ExploreEmbedded/ATmega32_ExploreUltraAvrDevKit/Others/Fritzing images/Interfacing KS0108 based JHD12864E Graphics LCD with Atmega32 _bb1.png

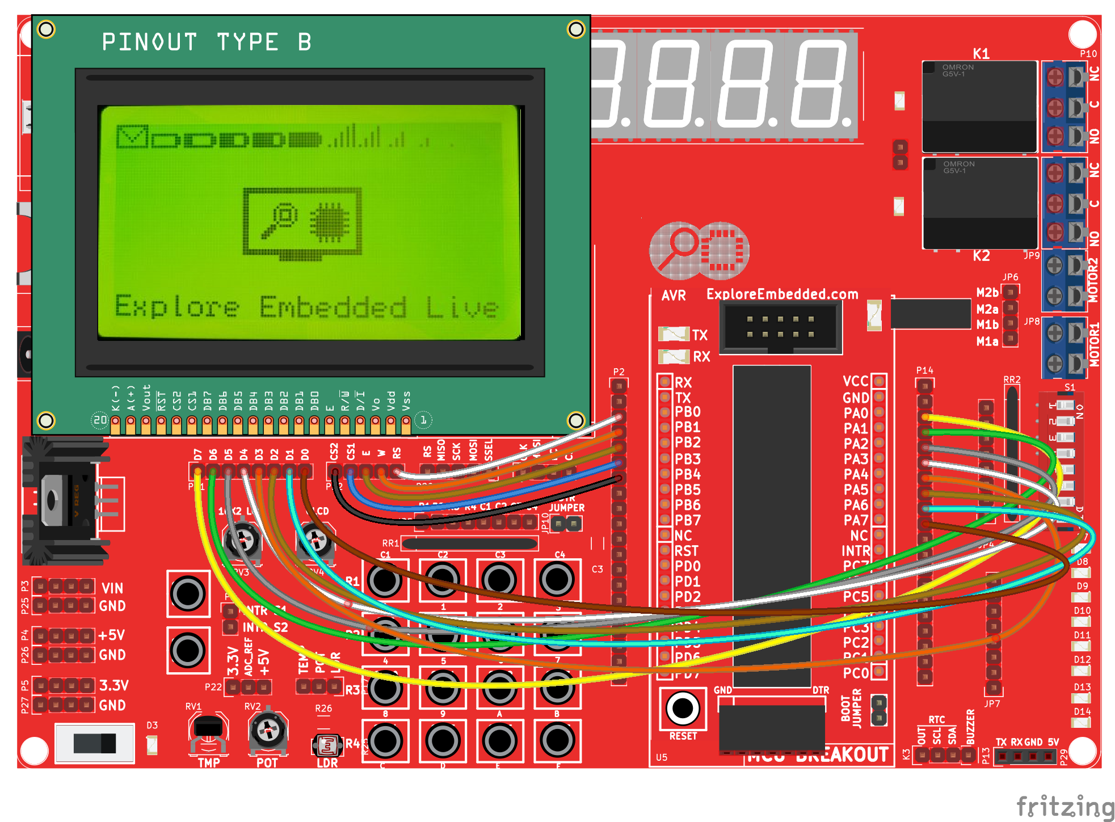
Others/Fritzing images/Interfacing KS0108 based JHD12864E Graphics LCD with Atmega32 _bb1.png
