ExploreEmbedded/ATmega32_ExploreUltraAvrDevKit/Others/Fritzing images/LCD 16X2_AVR.png

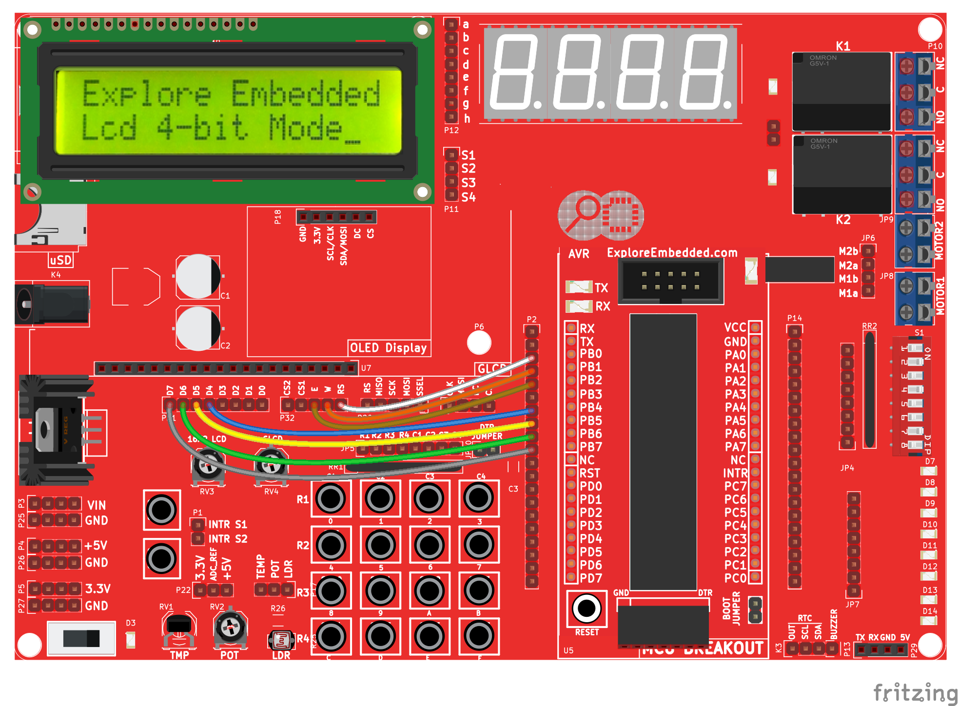
Others/Fritzing images/LCD 16X2_AVR.png
