ExploreEmbedded/ATmega32_ExploreUltraAvrDevKit/Bootloader/README.md

Serial bootloader for Atmega32

# optiboot_atmega32_16Mhz.hex: Fuse Bits
```
low_fuses=0xff
high_fuses=0xde
extended_fuses=0x00
lock_bits=0x0F

Baud Rate=19200
```

Check the below link for flashing the .hex file using XploreFlash tool
https://exploreembedded.com/wiki/Setting_Up_Starter_AVR
Do comment below this utorial for any issues.
