ExploreEmbedded/ATmega32_ExploreUltraAvrDevKit/Others/Fritzing images/10b-Keypad_LCD_bb.png

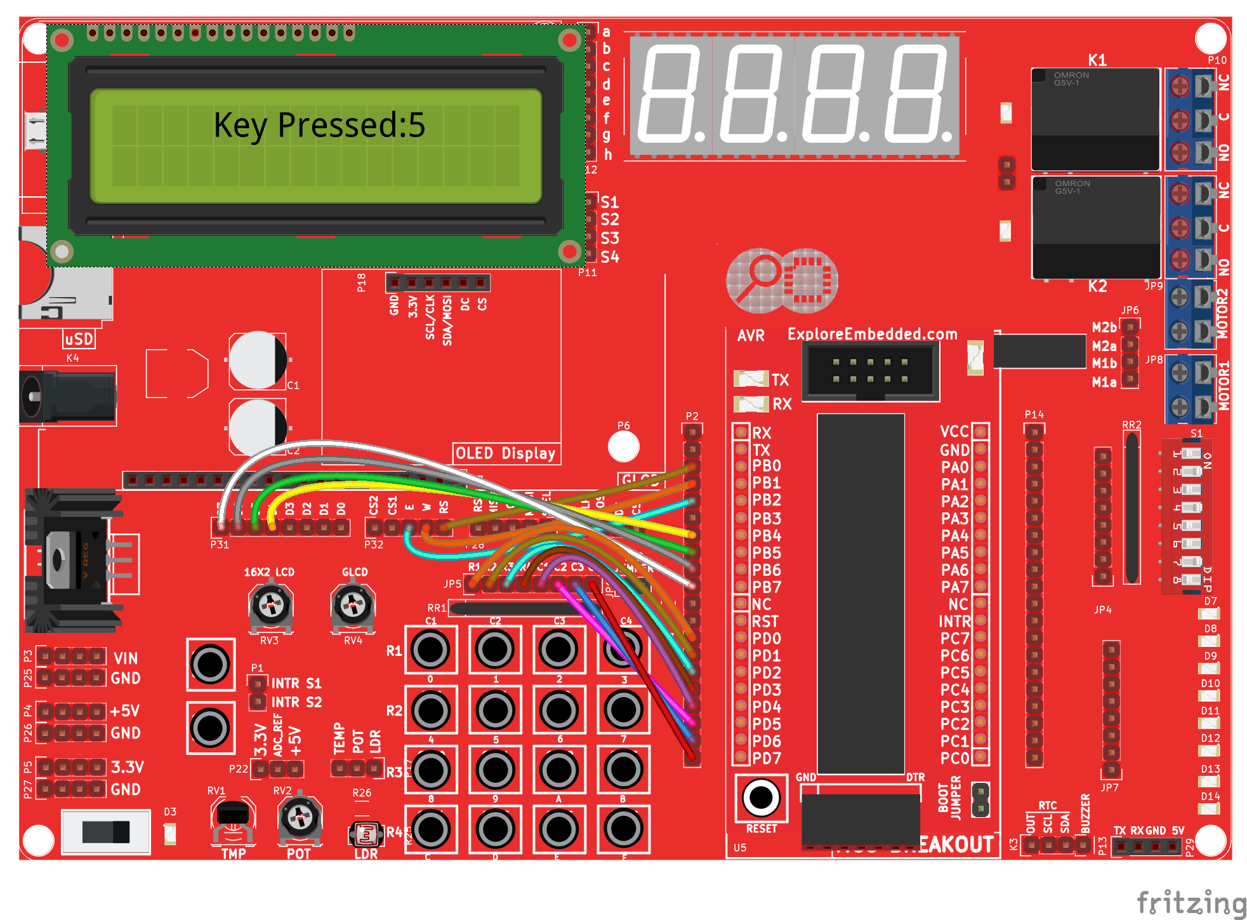
Others/Fritzing images/10b-Keypad_LCD_bb.png
