ExploreEmbedded/ATmega32_ExploreUltraAvrDevKit/Others/Fritzing images/Controlling AC device using Relay_AVR_bb.png

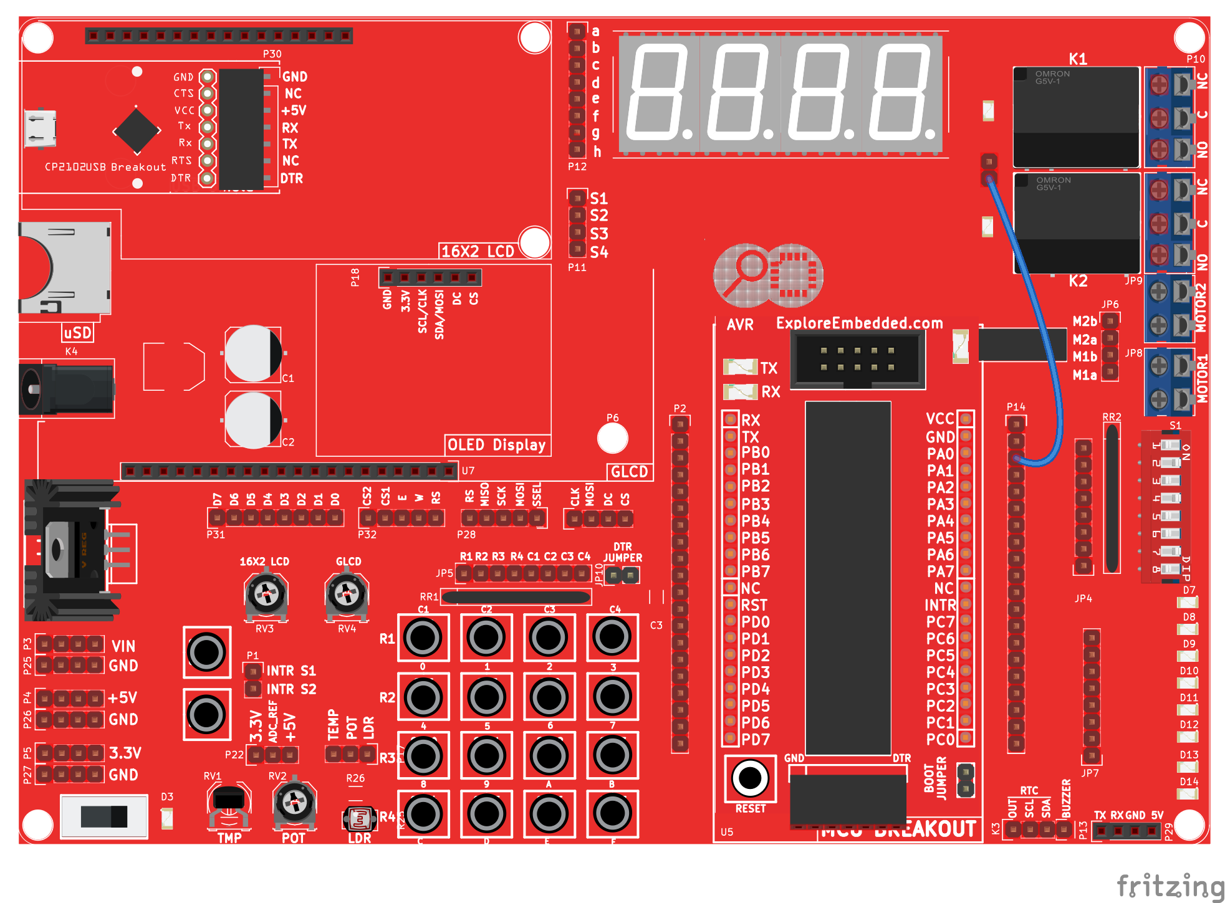
Others/Fritzing images/Controlling AC device using Relay_AVR_bb.png
