ExploreEmbedded/ATmega32_ExploreUltraAvrDevKit/Others/Fritzing images/EXT_Interrupt_Edge_Level.png

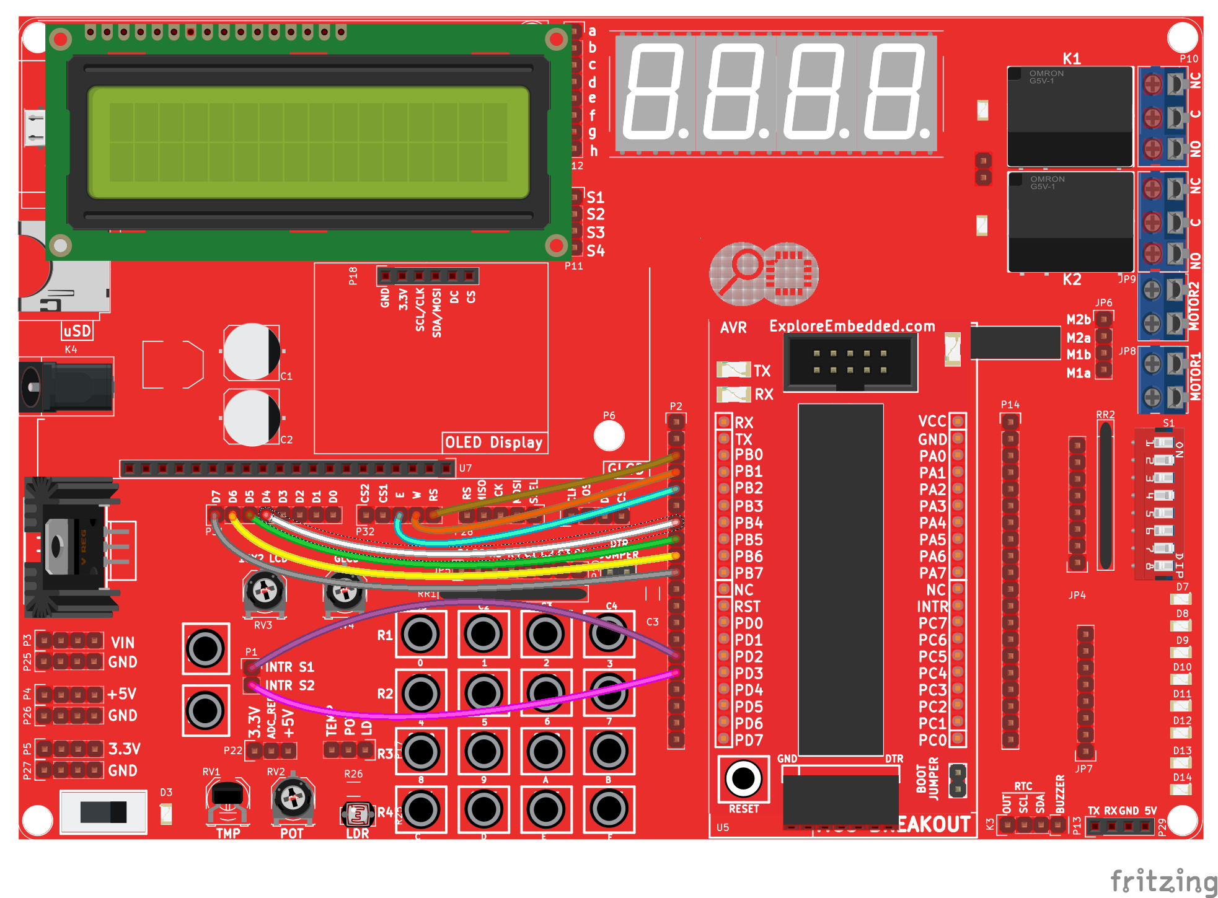
Others/Fritzing images/EXT_Interrupt_Edge_Level.png
