ExploreEmbedded/ATmega32_ExploreUltraAvrDevKit/Others/Fritzing images/Interfacing Seven Segment Displays with AVR_bb.png

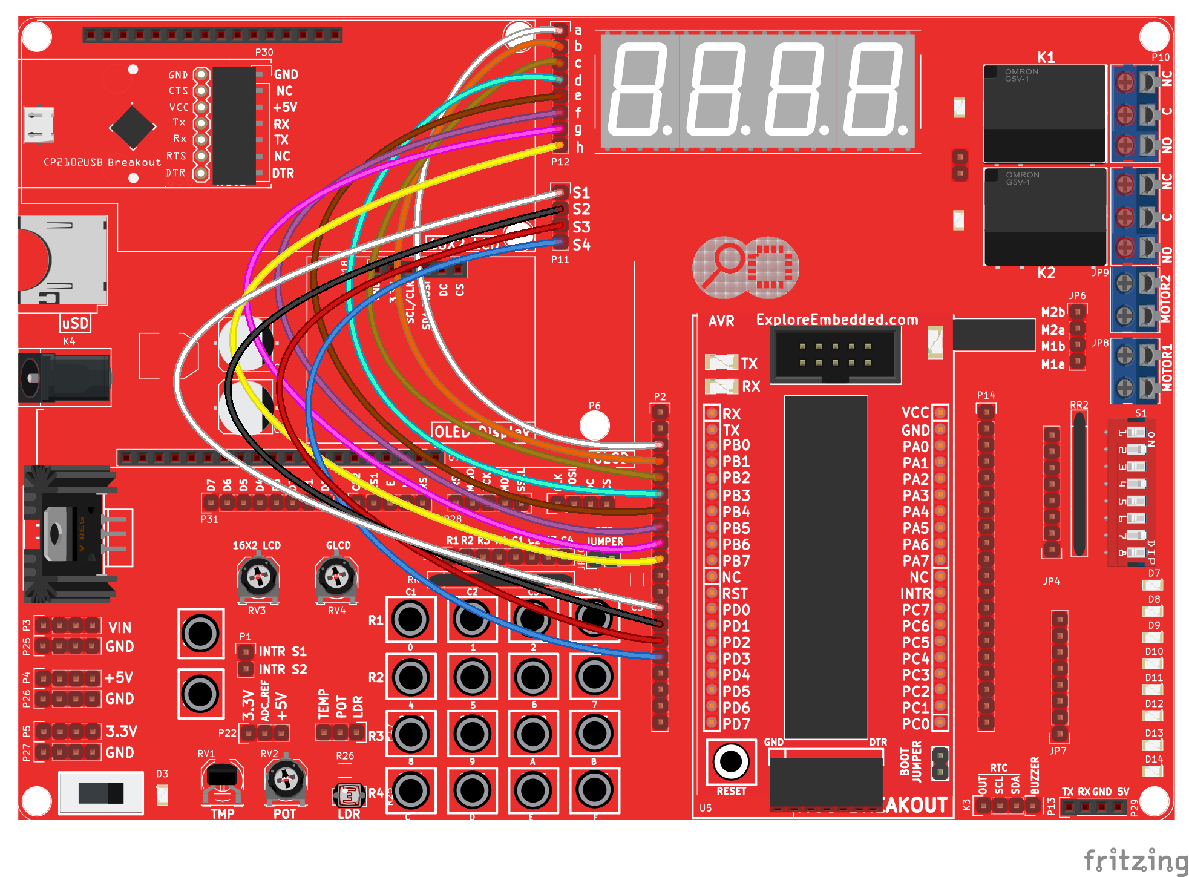
Others/Fritzing images/Interfacing Seven Segment Displays with AVR_bb.png
