ExploreEmbedded/ATmega32_ExploreUltraAvrDevKit/Others/Fritzing images/Real Time Clock(DS1307) with AVR_LCD_RTC.png

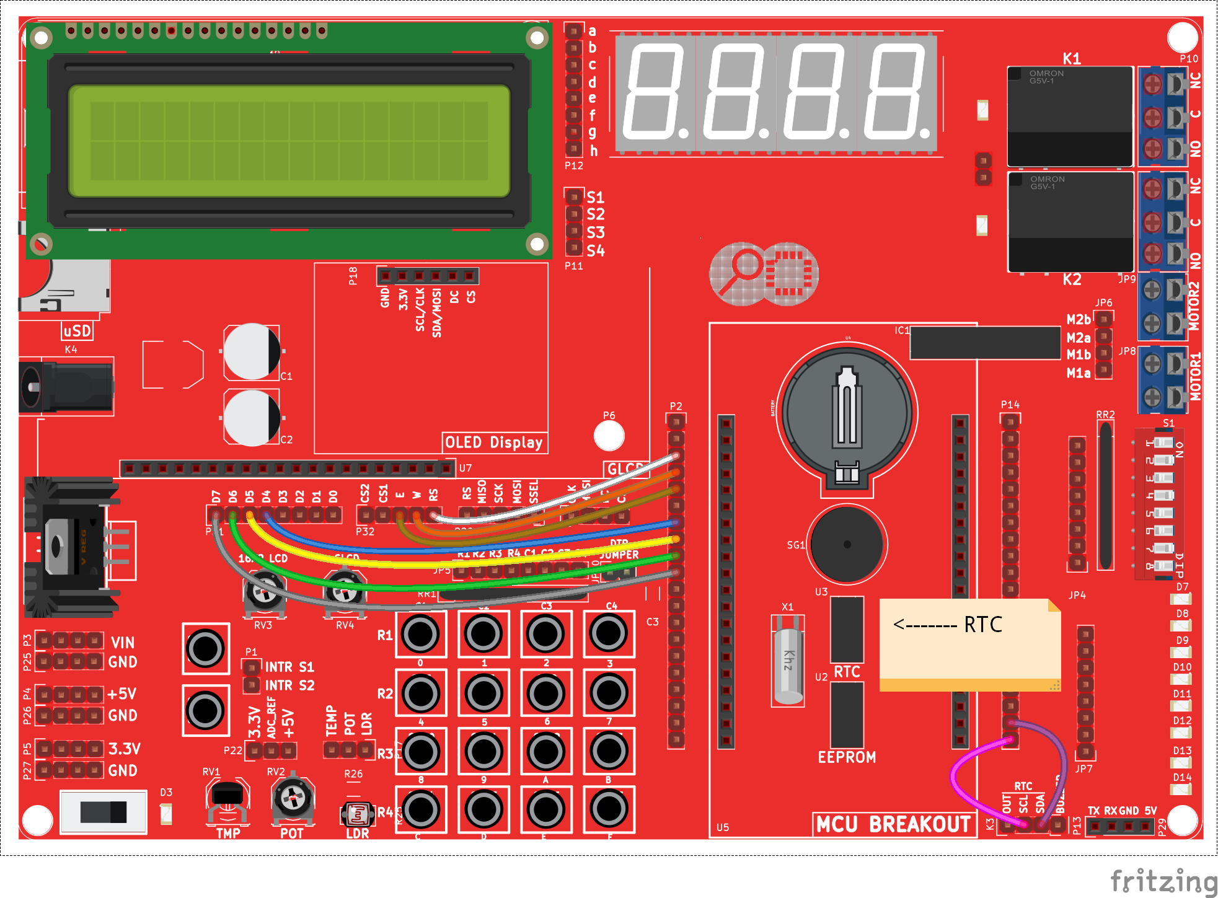
Others/Fritzing images/Real Time Clock(DS1307) with AVR_LCD_RTC.png
