ExploreEmbedded/ATmega32_ExploreUltraAvrDevKit/Hardware Design/Explore Ultra One base board/BOM.xlsx

Id | Designator | Package | Quantity | Designation | 50 quantity | Price | Vendor
1 | SW20 | SPSPT_XL | 1 | SPST | 50
2 | LCD1 | WC1602A | 1 | LCD_2X16_SIL | 50
3 | C1,C2 | c_elec_8x10.5 | 2 | 100uF, 25V | 100
4 | C3 | C_1206_HandSoldering | 1 | 0.1uf | 50
5 | C4 | C_1206_HandSoldering | 1 | 100nF | 50
6 | C5 | C_1206_HandSoldering | 1 | 10uF | 50
7 | D2 | LED-1206 RED | 1 | RL1 | 50
8 | D3,D7,D8,D9,D10,D11,D12,D13,D14,D16 | LED-1206 GREEN | 10 | LED | 500
9 | D4 | LED-1206 GREEN | 1 | RL2 | 50
10 | D5,D6 | Diode-SMA_Handsoldering | 2 | 1N4007 SOD80 | 100
11 | D15 | Diode-SMA_Handsoldering | 1 | 1N4007 SOD80 | 50
12 | D17,D18,D19 | Diode-SMA_Handsoldering | 3 | ZENER 3.3V SOD80 | 150
13 | IC1 | DIP-16__300_ELL | 1 | L293D | 50
14 | IC2 | SOT-223 | 1 | LM1117(3V3) | 50
15 | JP2,JP3 | bornier3 3PIN | 2 | MKDSN | 100
16 | JP4 | Pin_Header_Straight_1x08 | 1 | SWITCH_ARRAY | 50 | 4 stick male
17 | JP5 | Pin_Header_Straight_1x08 | 1 | MATRIX 4X4 | 50 | 2 stick Female
18 | JP6 | Pin_Header_Straight_1x04 | 1 | MOTAR CNTRL | 50 | 1 stick Female R/A
19 | JP7 | Pin_Header_Straight_1x08 | 1 | led array | 50 | 1 stick male long
20 | JP8,JP9 | bornier2 2PIN | 2 | MKDSN | 100
21 | K3 | Pin_Header_Straight_1x03 | 1 | I2C | 50
22 | K4 | BARREL_JACK | 1 | CONN_3 | 50
23 | P3,P4,P5,P25,P26,P27,P29,P17 | Pin_Header_Straight_1x04 | 8 | CONN_01X04 | 400
25 | P11 | Pin_Header_Straight_1x04 | 1 | CONN_4 | 50
26 | P12 | Pin_Header_Straight_1x08 | 1 | CONN_8 | 50
27 | P13 | Pin_Header_Straight_1x01 | 1 | CONN_1 | 50
28 | P22,P15 | Pin_Header_Straight_1x03 | 2 | CONN_01X03 | 100
29 | P28,P32 | Pin_Header_Straight_1x05 | 2 | CONN_01X05 | 100
30 | Q2,Q3,Q4,Q5,Q6,Q7,Q1 | SMD BC847 | 7 | BC847 SMD | 350
31 | R1,R2,R17,R18,R26 | R_1206_HandSoldering | 5 | 10k | 250
32 | R3,R4,R5,R6,R7,R8,R9,R19 | R_1206_HandSoldering | 8 | 1K | 400
33 | R10 | R_1206_HandSoldering | 1 | 10K | 50
34 | R13 | R_1206_HandSoldering | 1 | 2.2k | 50
35 | R14 | R_1206_HandSoldering | 1 | 3.3k | 50
36 | R15 | R_1206_HandSoldering | 1 | 3.3K | 50
37 | R16,R27,R29,R30,R31,R32,R33,R34,R35 | R_1206_HandSoldering | 9 | 470 | 450
38 | R20,R28 | R_1206_HandSoldering | 2 | 33K | 100
39 | R21,R22,R23,R24 | R_1206_HandSoldering | 4 | 68 | 200
40 | RR1,RR2 | Pull uP array 10k | 2 | RR8 | 100
41 | RV1 | LM35 | 1 | TS | 50
42 | RV2 | Potentiometer_Triwood_RM-065 | 1 | POT | 50
43 | RV3,RV4 | Potentiometer_Triwood_RM-065 | 2 | VO | 100
44 | S1 | DIP-16__300_ELL | 1 | SW_DIP-8 | 50
45 | SD1 | Micro_SD | 1 | MICRO_SD | 50
46 | SG1 | Buzzer_12x9.5RM7.6 | 1 | BUZZERPTH | 50
47 | SW2 | SW_PUSH_SMALL_2pin_3D_xl | 1 | C | 50
48 | SW3 | SW_PUSH_SMALL_2pin_3D_xl | 1 | D | 50
49 | SW4 | SW_PUSH_SMALL_2pin_3D_xl | 1 | E | 50
50 | SW5 | SW_PUSH_SMALL_2pin_3D_xl | 1 | F | 50
51 | SW6 | SW_PUSH_SMALL_2pin_3D_xl | 1 | 9 | 50
52 | SW7 | SW_PUSH_SMALL_2pin_3D_xl | 1 | 0 | 50
53 | SW8 | SW_PUSH_SMALL_2pin_3D_xl | 1 | A | 50
54 | SW9 | SW_PUSH_SMALL_2pin_3D_xl | 1 | B | 50
55 | SW10 | SW_PUSH_SMALL_2pin_3D_xl | 1 | 5 | 50
56 | SW11 | SW_PUSH_SMALL_2pin_3D_xl | 1 | 6 | 50
57 | SW12 | SW_PUSH_SMALL_2pin_3D_xl | 1 | 7 | 50
58 | SW13 | SW_PUSH_SMALL_2pin_3D_xl | 1 | 8 | 50
59 | SW14 | SW_PUSH_SMALL_2pin_3D_xl | 1 | 1 | 50
60 | SW15 | SW_PUSH_SMALL_2pin_3D_xl | 1 | 2 | 50
61 | SW16 | SW_PUSH_SMALL_2pin_3D_xl | 1 | 3 | 50
62 | SW17 | SW_PUSH_SMALL_2pin_3D_xl | 1 | 4 | 50
63 | SW18 | SW_PUSH_SMALL_2pin_3D_xl | 1 | INT0 | 50
64 | SW19 | SW_PUSH_SMALL_2pin_3D_xl | 1 | INT1 | 50
65 | U2 | DIP-8__300_ELL and IC | 1 | 24C16 | 50
66 | U3 | DIP-8__300_ELL and IC | 1 | DS1307 | 50
67 | U4 | BATT_rtc_XL | 1 | BATTERY | 50
68 | U7 | Pin_Header_Straight_1x20 | 1 | LCD-jhd12864e-xl | 50
69 | JP1 | Pin_Header_Straight_1x02 | 1 | RELAY | 50
70 | JP10 | Pin_Header_Straight_1x02 | 1 | JUMPER | 50
71 | K1,K2 | 5V AIFU Relays | 2 | RELAYPTH | 100
72 | U1 | 1A regulator | 1 | 7805 | 50
73 | R25 | Pin_Header_Straight_1x02 | 1 | LDR | 50
74 | P30 | Pin_Header_Straight_1x07 | 1 | CONN_01X07 | 50
75 | P31 | Pin_Header_Straight_1x08 | 1 | CONN_01X08 | 50
76 | P1 | Pin_Header_Straight_1x02 | 1 | CONN_01X02 | 50
77 | AFF2,AFF3,AFF4,AFF1 | 7SegmentLED_LT542 | 4 | LT542 CA | 200
79 | P2,P14 | Pin_Header_Straight_1x20 | 2 | CONN_01X20 | 100
80 | X1 | RTC_Crystal | 1 | 32.768kHZ | 50
