ExploreEmbedded/ATmega32_ExploreUltraAvrDevKit/(list of files, cad)

Other CAD files:
Hardware Design/Explore Ultra One base board/MCU_BaseBoard-drl_map.dxf
Hardware Design/Explore Ultra One base board/MCU_BaseBoard-NPTH-drl_map.dxf
