ExploreEmbedded/ATmega32_ExploreUltraAvrDevKit/Hardware Design/Explore Ultra One base board/MCU_BaseBoard.pdf

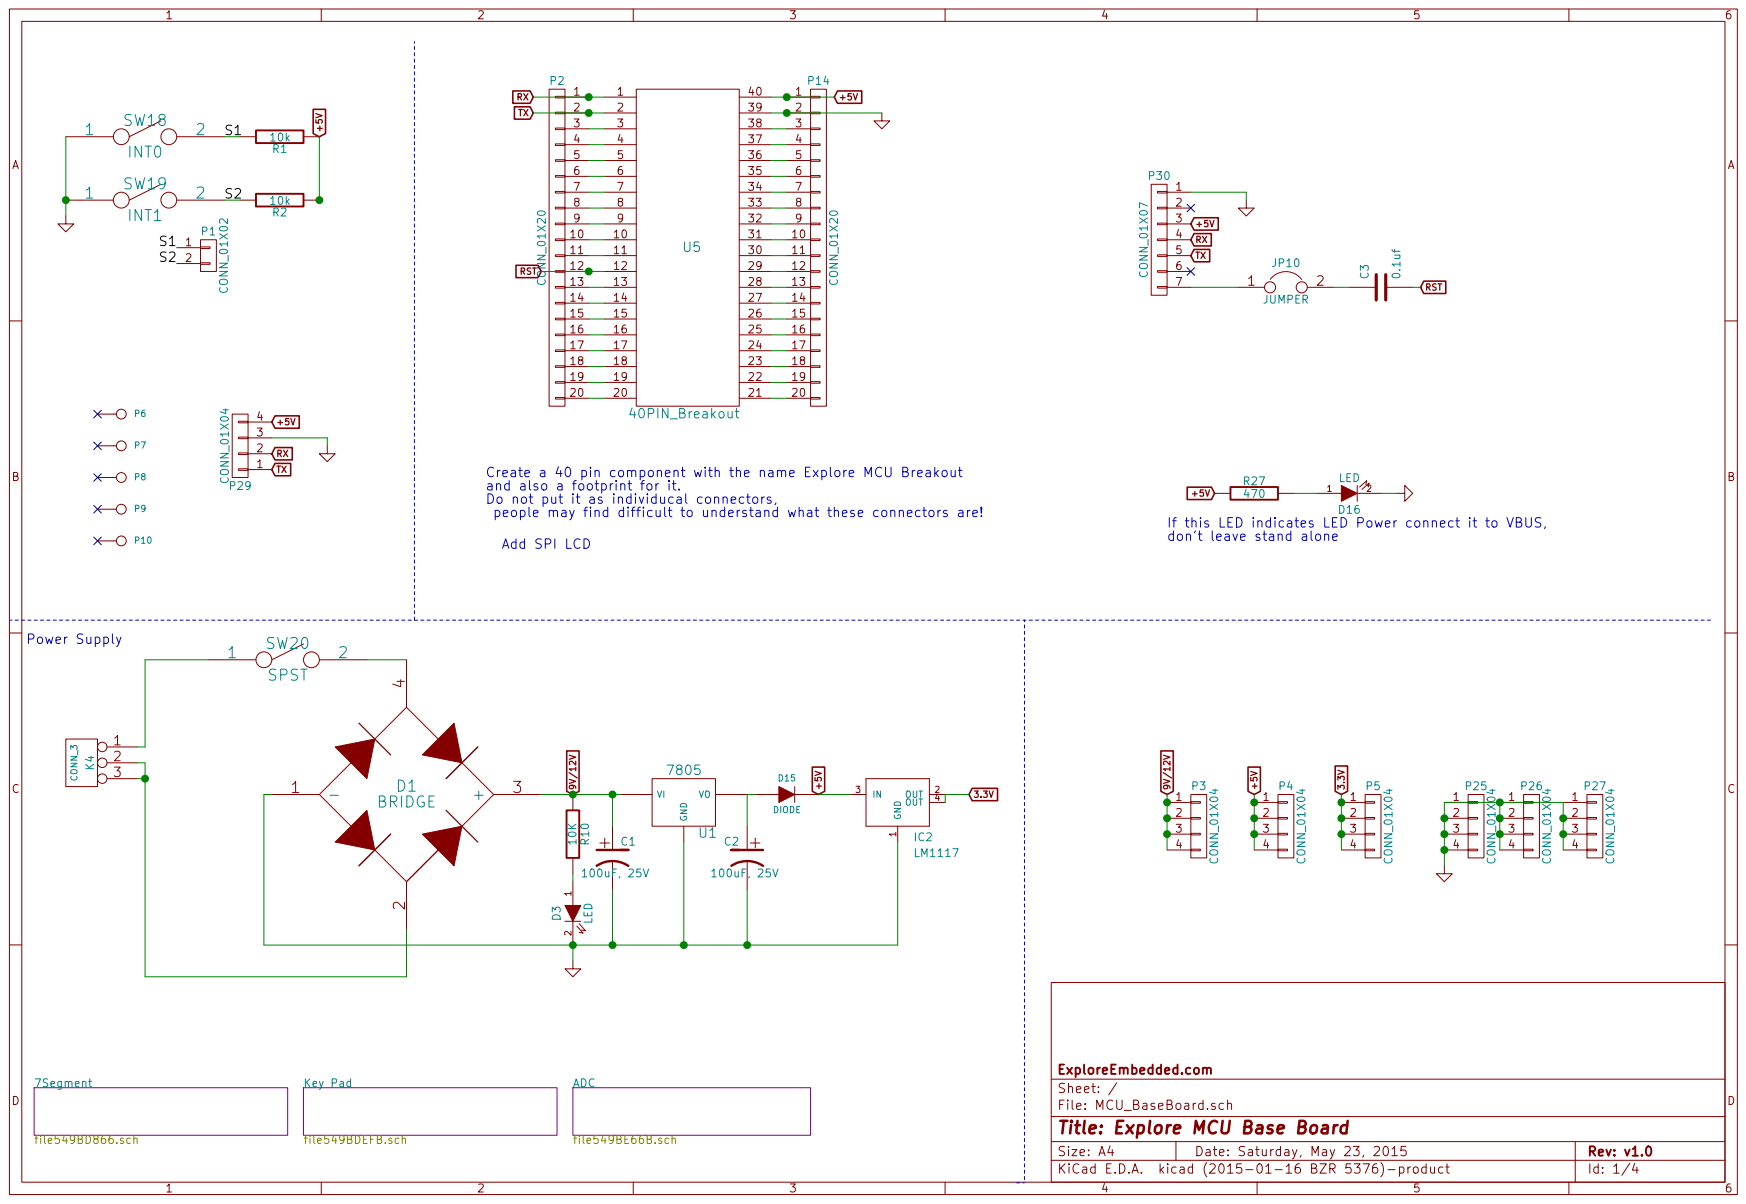
[picture p8: page 1]

6 6 | 35 6
7 7 | 34 7

9 9 | 32 9
10 10 | 31 10
11 11 | 30 11
12 12 | 29 12
13 13 | 28 13
14 14 | 27 14
15 15 | 26 15
16 16 | 25 16
17 17 | 24 17
18 18 | 23 18

7805 Create a 40 pin component with the name Explore MCU Breakout
and also a footprint for it.
Do not put it as individucal connectors,
people may find difficult to understand what these connectors are!
If this LED indicates LED Power connect it to VBUS, don't leave stand alone Add SPI LCD

File: MCU_BaseBoard.sch Sheet: / ExploreEmbedded.com

Id: 1/4 Title: Explore MCU Base Board

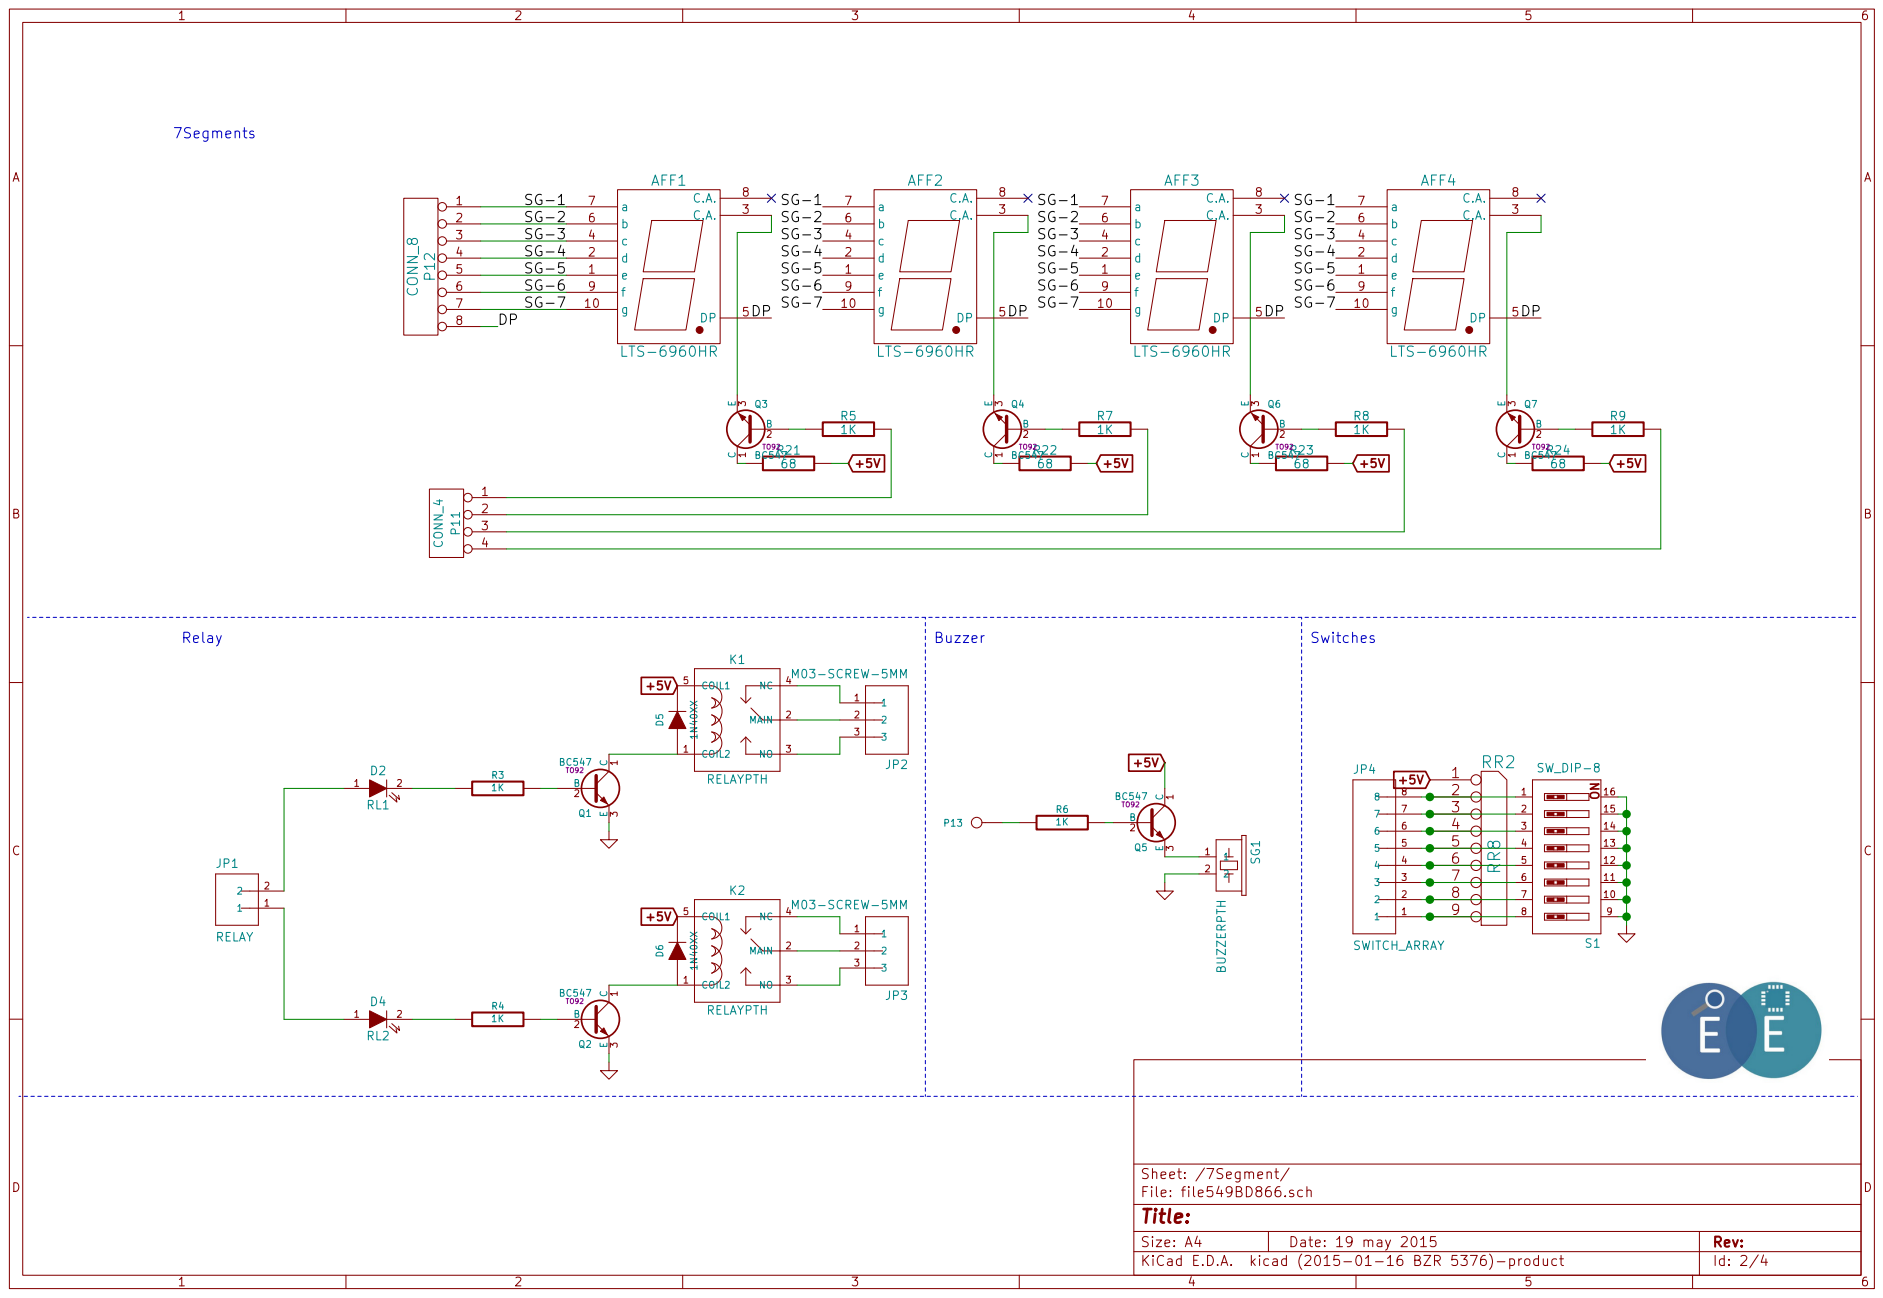
[picture p9: page 2]

Id: 2/4 Title: File: file549BD866.sch Sheet: /7Segment/

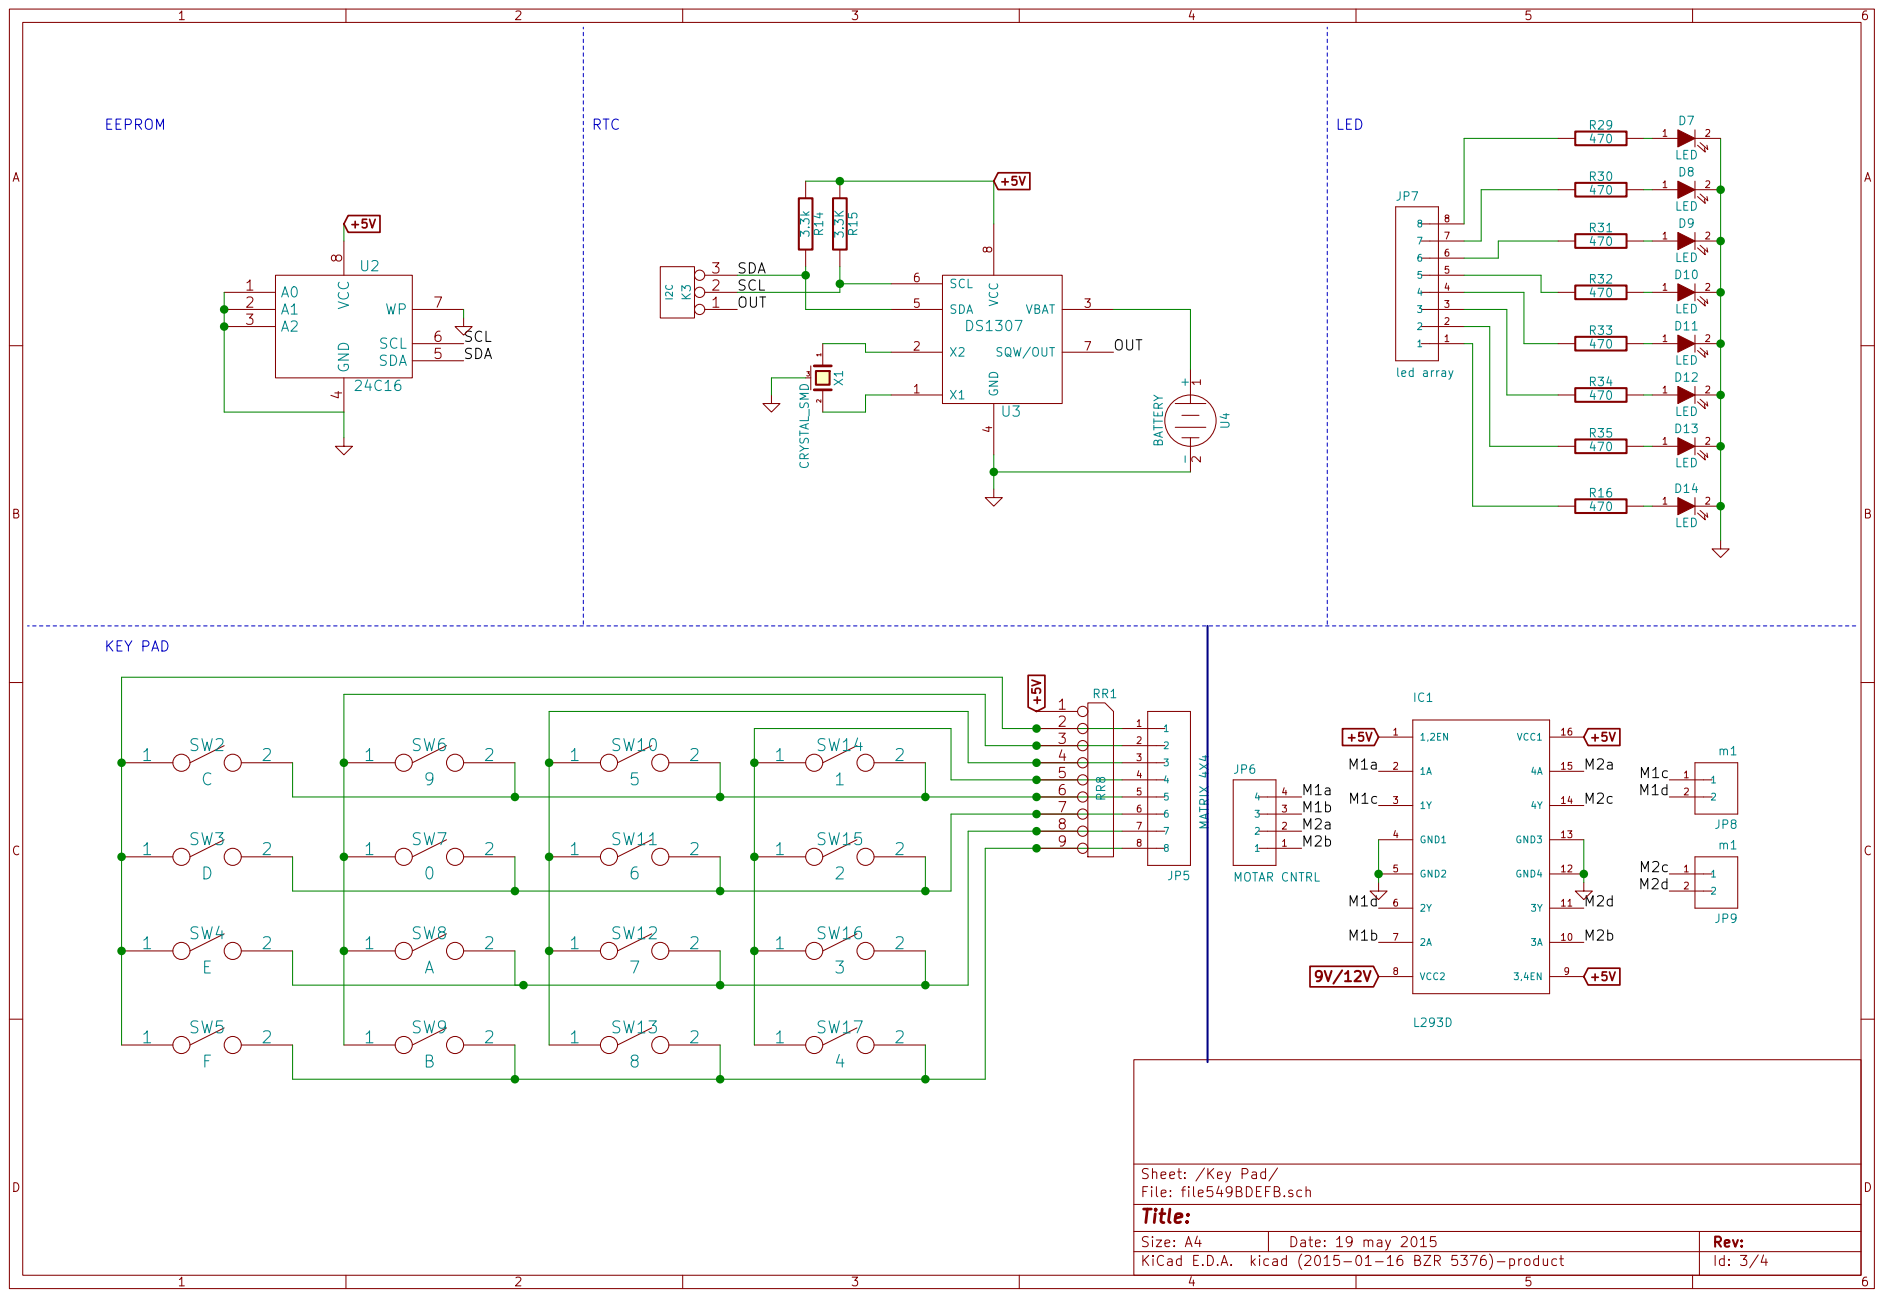
[picture p10: page 3]

4 SDA 5 SCL 6 SQW/OUT 7 VCC

Id: 3/4 Title: File: file549BDEFB.sch Sheet: /Key Pad/

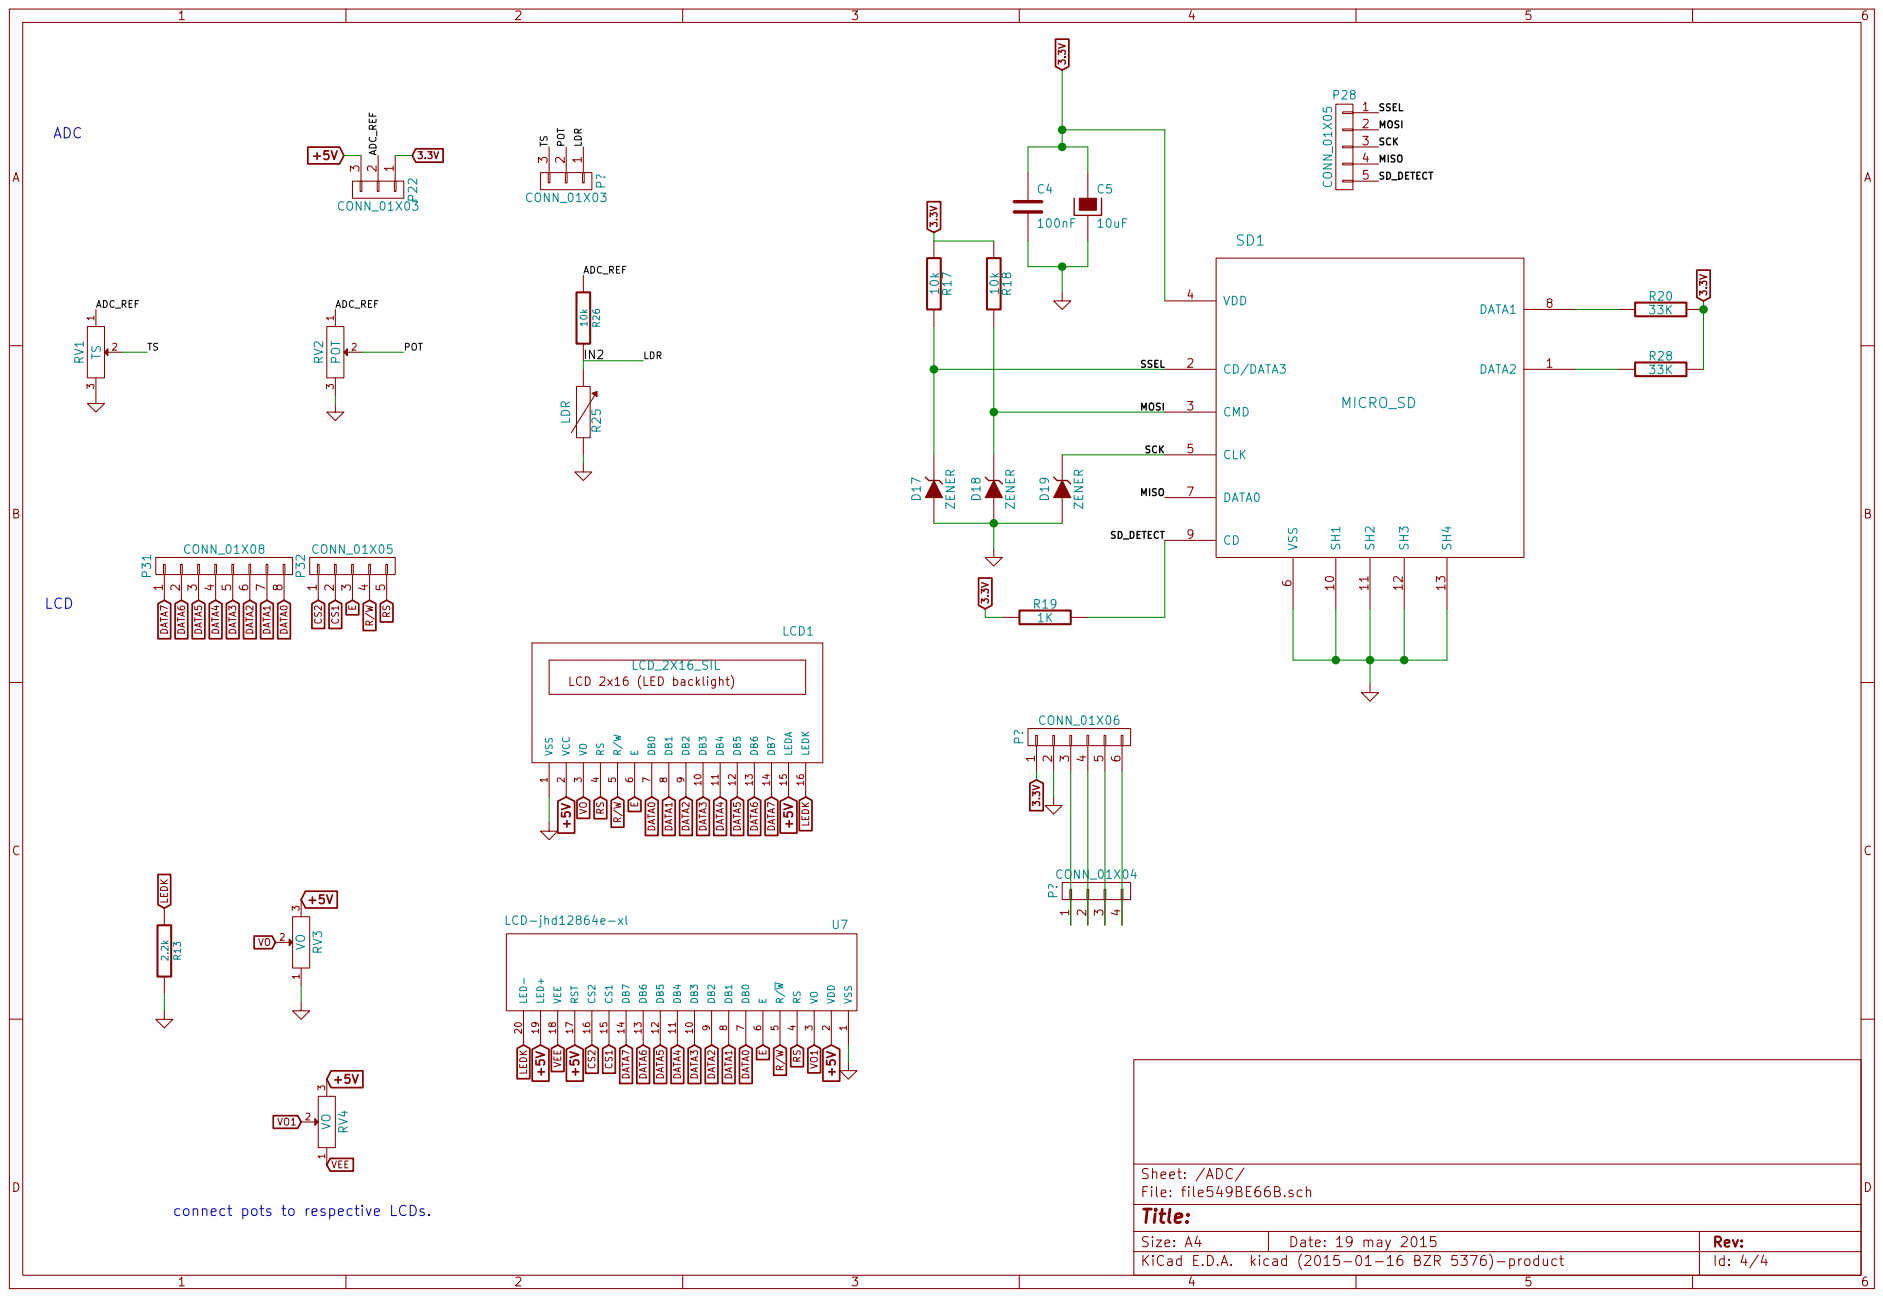
[picture p11: page 4]

33K SSEL MOSI SCK MISO

9 DB3 10 LED- 20 DB4 11 DB5 12 DB6 13 DB7 14 CS1 15 CS2 16 RST 17 VEE 18 LED+ 19 U7 LCD-jhd12864e-xl DATA7 DATA6 DATA5 DATA4 DATA3 DATA2 DATA1 DATA0E R/WRS CS2 CS1 2.2k R13

LCD 2x16 (LED backlight) VSS

Id: 4/4 Title: File: file549BE66B.sch Sheet: /ADC/

connect pots to respective LCDs.
