ExploreEmbedded/ATmega32_ExploreUltraAvrDevKit/Hardware Design/Atmega32 Breakout Board/40pin_AVRMCU.pdf

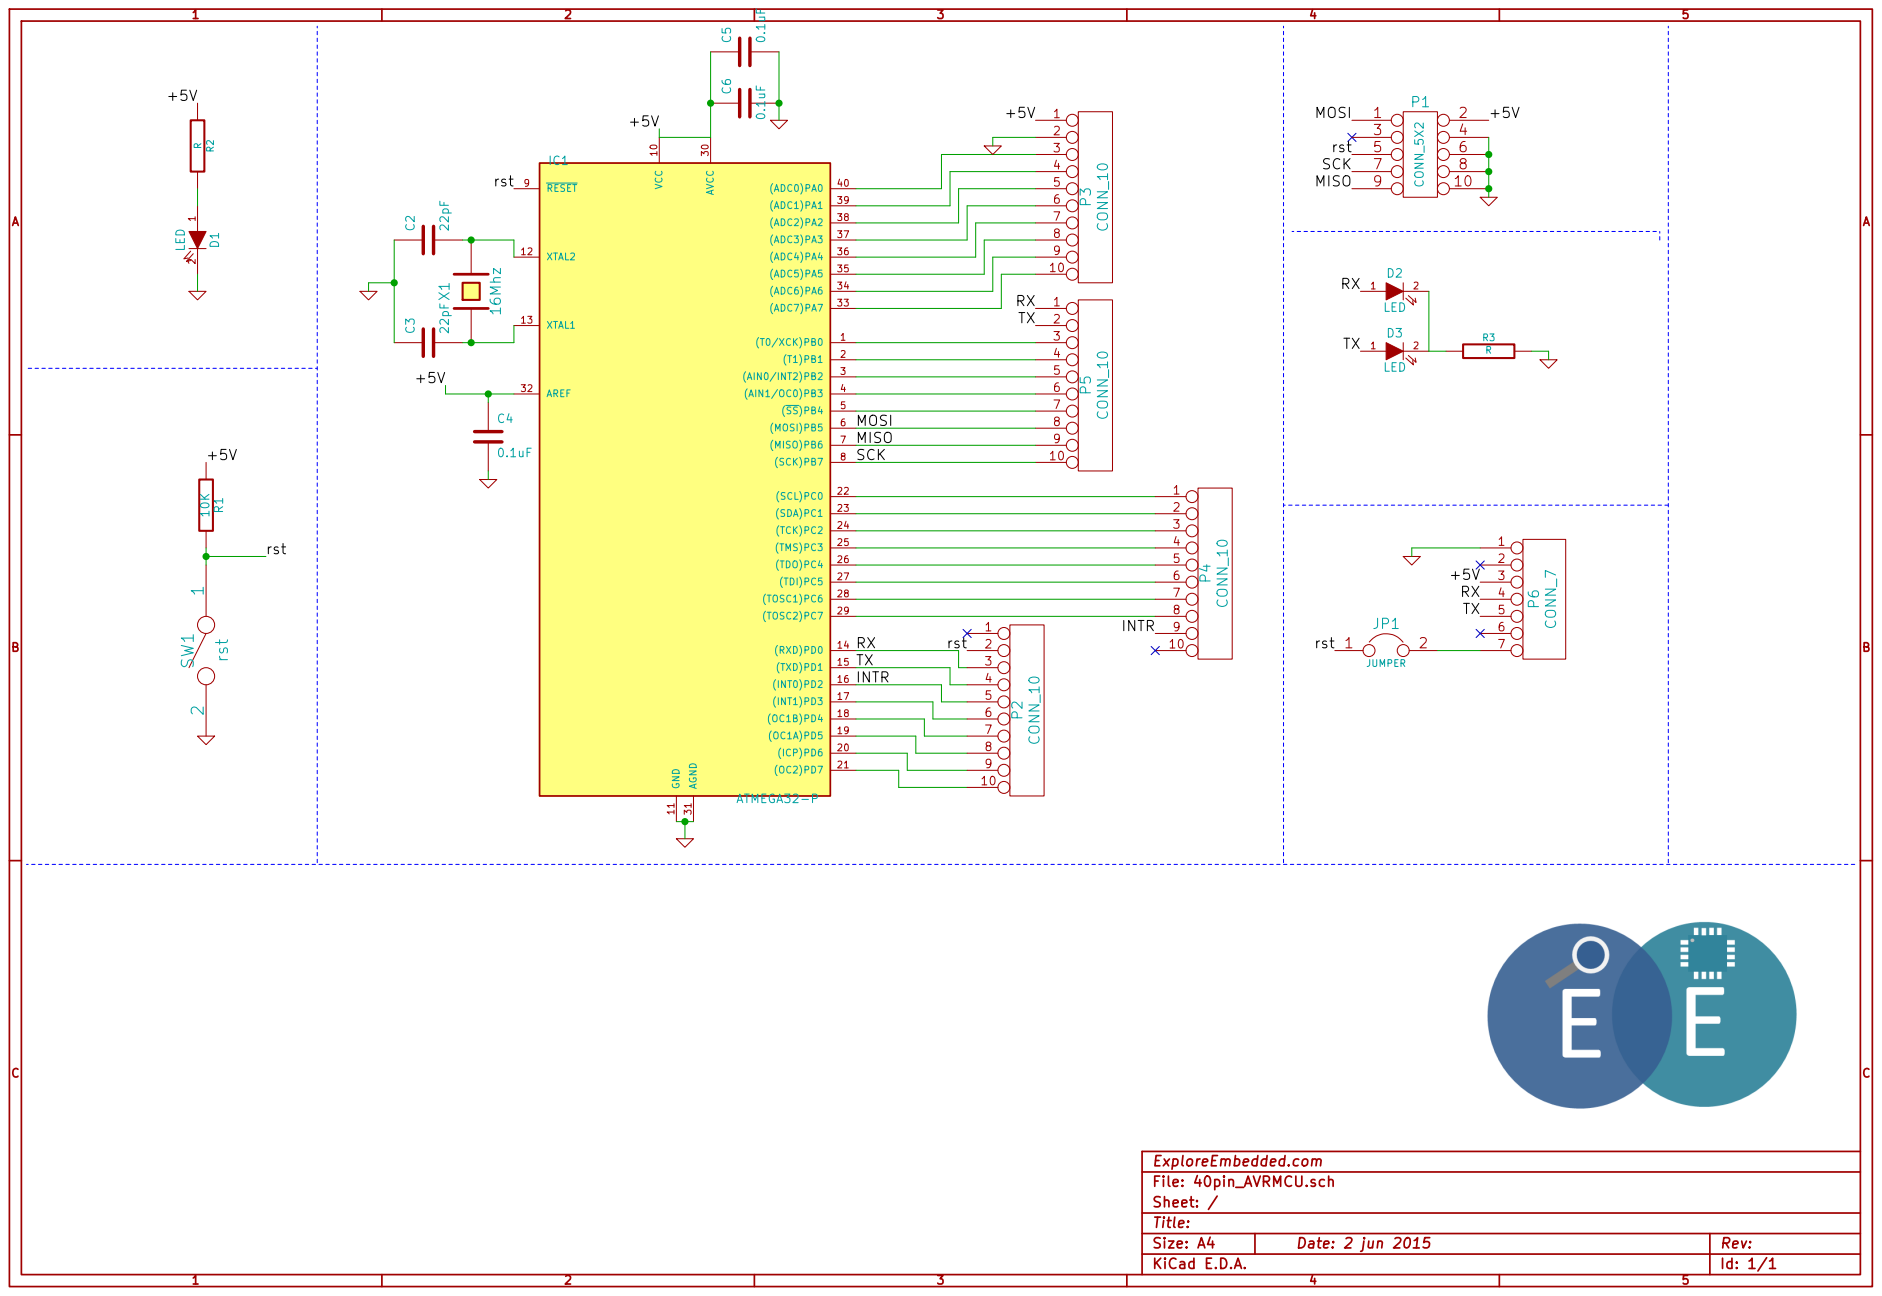
[picture p12: page 1]

TX
INTR

ExploreEmbedded.com
Id: 1/1 Title: File: 40pin_AVRMCU.sch
Sheet: /
