ExploreEmbedded/ATmega32_ExploreUltraAvrDevKit/(list of files, drawings)

Other design files:
Others/Fritzing images/10b-Keypad_LCD.fzz
Others/Fritzing images/Controlling AC device using Relay_AVR.fzz
Others/Fritzing images/EXT_Interrupt_Edge_Level.fzz
Others/Fritzing images/Interfacing KS0108 based JHD12864E Graphics LCD with Atmega32 .fzz
Others/Fritzing images/Interfacing Seven Segment Displays with AVR.fzz
Others/Fritzing images/LCD 16X2_AVR.fzz
Others/Fritzing images/Reading Temperature with AVR ADC.fzz
Others/Fritzing images/Reading Temperature with AVR ADC_TEMP.fzz
Others/Fritzing images/Real Time Clock(DS1307) with AVR_LCD.fzz
