ExploreEmbedded/ATmega32_ExploreUltraAvrDevKit/Hardware Design/Atmega32 Breakout Board/40pin_AVRMCU.kicad_pcb

## KiCad design Hardware Design/Atmega32 Breakout Board/40pin_AVRMCU.kicad_pcb (2016-04-19)

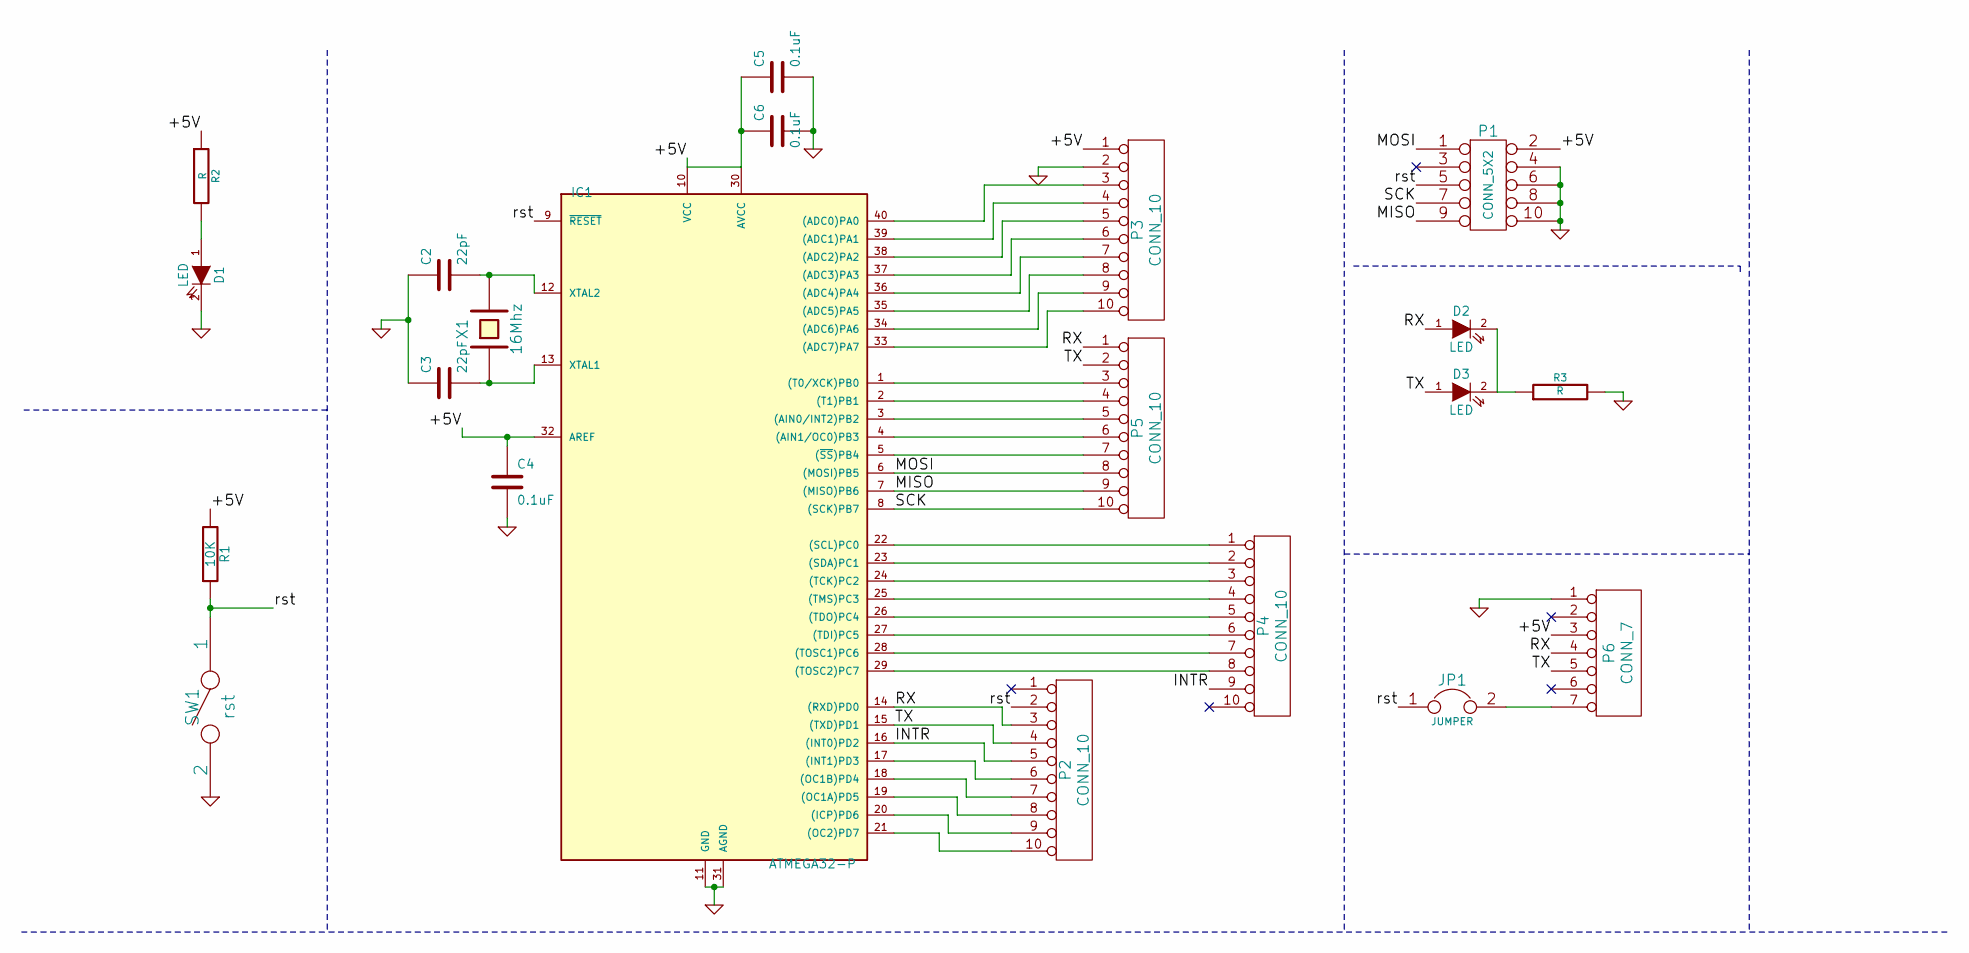
[picture p13: schematic 40pin_AVRMCU.sch]

Parts:
C2, C3: 22pF
C4, C5, C6: 0.1uF
D1, D2, D3: LED
IC1: ATMEGA32-P; DIL40
JP1: JUMPER
P1: CONN_5X2
P2, P3, P4, P5: CONN_10
P6: CONN_7
R1: 10K
R2, R3: R
SW1: rst
X1: 16Mhz

Connections:
/+5V: C4.1, C5.1, C6.1, IC1.10 (VCC), IC1.30 (AVCC), IC1.32 (AREF), P1.2, P3.1, P6.3, R1.2, R2.1
/INTR: IC1.16 ((INT0)PD2), P2.5, P4.9
/MISO: IC1.7 ((MISO)PB6), P1.9, P5.9
/MOSI: IC1.6 ((MOSI)PB5), P1.1, P5.8
/RX: D2.1 (A), IC1.14 ((RXD)PD0), P2.3, P5.1, P6.4
/SCK: IC1.8 ((SCK)PB7), P1.7, P5.10
/TX: D3.1 (A), IC1.15 ((TXD)PD1), P2.4, P5.2, P6.5
/rst: IC1.9 (~RESET), JP1.1, P1.5, P2.2, R1.1, SW1.1
GND: C2.1, C3.1, C4.2, C5.2, C6.2, D1.2 (K), IC1.11 (GND), IC1.31 (AGND), P1.4, P1.6, P1.8, P1.10, P3.2, P6.1, R3.2, SW1.2
unnamed: IC1.34 ((ADC6)PA6), P3.9
unnamed: IC1.33 ((ADC7)PA7), P3.10
unnamed: IC1.35 ((ADC5)PA5), P3.8
unnamed: IC1.36 ((ADC4)PA4), P3.7
unnamed: IC1.37 ((ADC3)PA3), P3.6
unnamed: IC1.39 ((ADC1)PA1), P3.4
unnamed: IC1.40 ((ADC0)PA0), P3.3
unnamed: IC1.38 ((ADC2)PA2), P3.5
unnamed: IC1.20 ((ICP)PD6), P2.9
unnamed: IC1.2 ((T1)PB1), P5.4
unnamed: IC1.1 ((T0/XCK)PB0), P5.3
unnamed: IC1.21 ((OC2)PD7), P2.10
unnamed: IC1.3 ((AIN0/INT2)PB2), P5.5
unnamed: IC1.19 ((OC1A)PD5), P2.8
unnamed: IC1.18 ((OC1B)PD4), P2.7
unnamed: IC1.5 ((~SS~)PB4), P5.7
unnamed: IC1.4 ((AIN1/OC0)PB3), P5.6
unnamed: D2.2 (K), D3.2 (K), R3.1
unnamed: JP1.2, P6.7
unnamed: IC1.17 ((INT1)PD3), P2.6
unnamed: D1.1 (A), R2.2
unnamed: C2.2, IC1.12 (XTAL2), X1.2
unnamed: IC1.24 ((TCK)PC2), P4.3
unnamed: IC1.23 ((SDA)PC1), P4.2
unnamed: IC1.22 ((SCL)PC0), P4.1
unnamed: IC1.29 ((TOSC2)PC7), P4.8
unnamed: IC1.28 ((TOSC1)PC6), P4.7
unnamed: IC1.27 ((TDI)PC5), P4.6
unnamed: IC1.26 ((TDO)PC4), P4.5
unnamed: IC1.25 ((TMS)PC3), P4.4
unnamed: C3.2, IC1.13 (XTAL1), X1.1

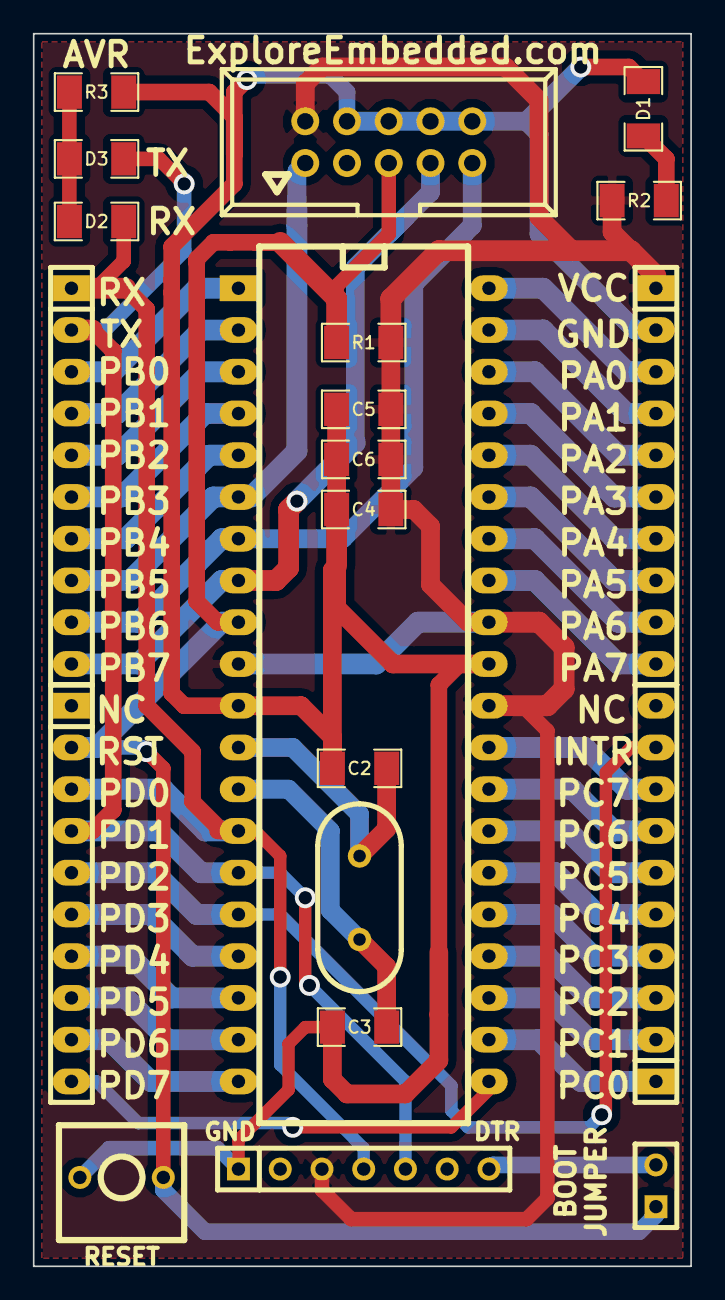
[picture p14: board 40pin_AVRMCU.kicad_pcb from above]

Board: 2 copper layers, 40.0 x 75.0 mm, 21 parts (0 on the bottom side), 40 nets.
