ExploreEmbedded/ATmega32_ExploreUltraAvrDevKit/Hardware Design/Explore Ultra One base board/MCU_BaseBoard.kicad_pcb

## KiCad design Hardware Design/Explore Ultra One base board/MCU_BaseBoard.kicad_pcb (2016-04-19)

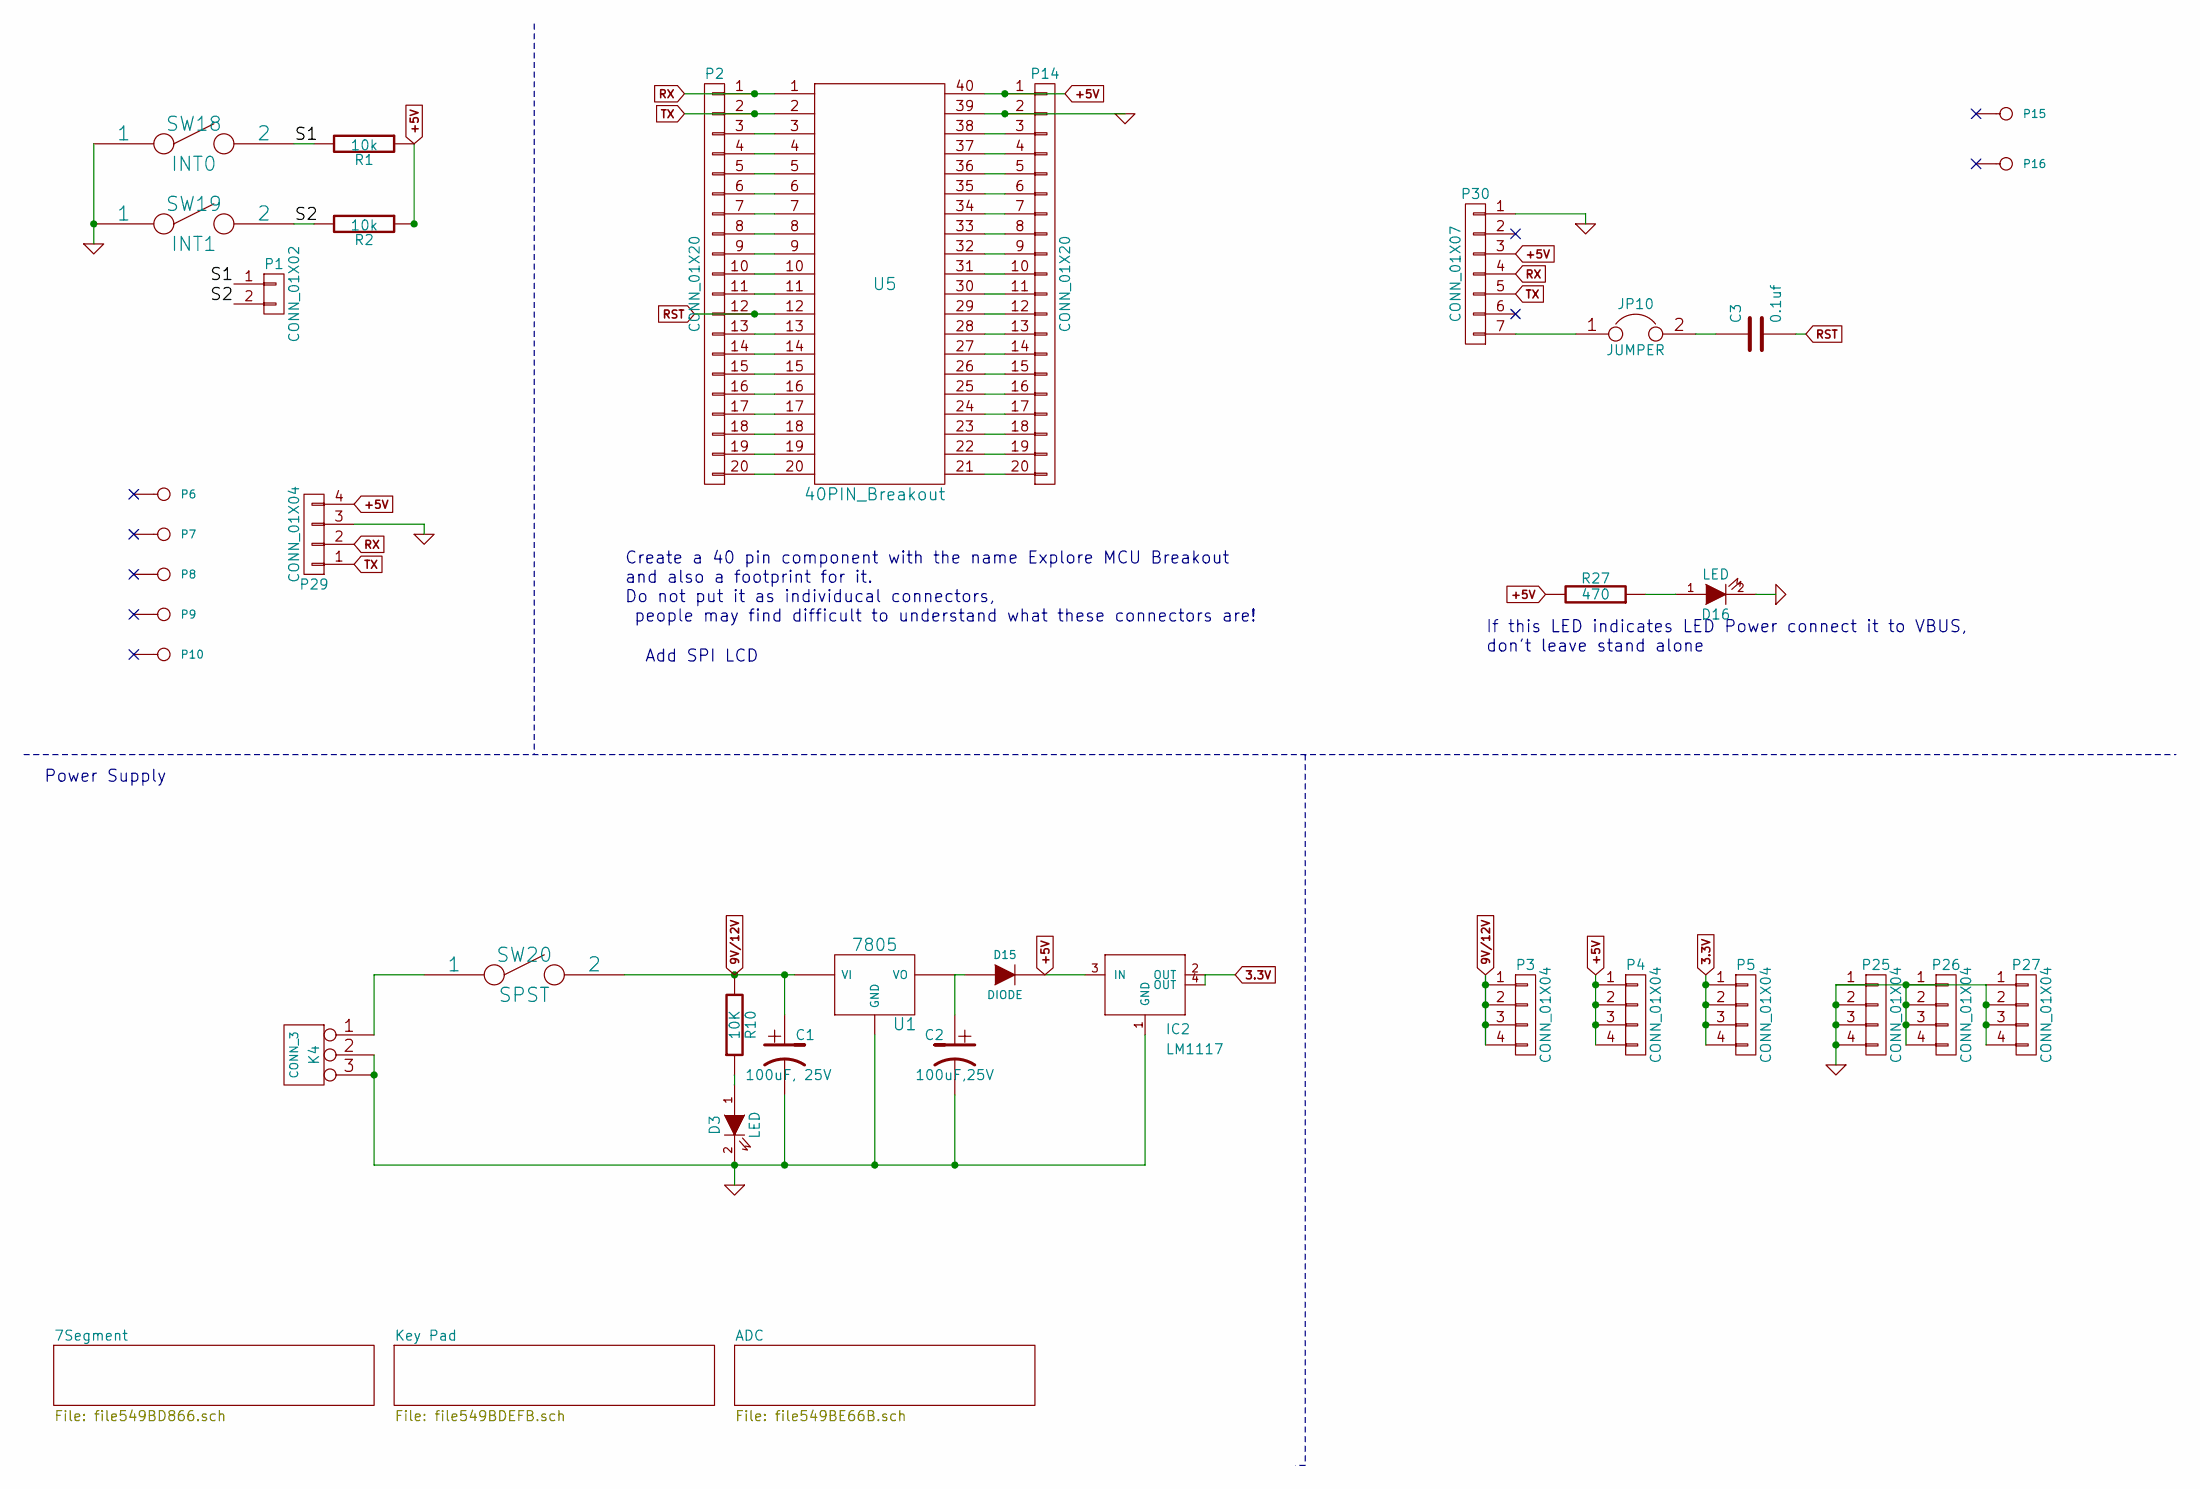
[picture p15: schematic MCU_BaseBoard.sch, Explore MCU Base Board]

Parts:
C1: 100uF, 25V
C2: 100uF,25V
C3: 0.1uf
D3, D16: LED
D15: DIODE
IC2: LM1117
JP10: JUMPER
K4: CONN_3
P1: CONN_01X02
P2, P14: CONN_01X20
P3, P4, P5, P25, P26, P27, P29: CONN_01X04
P6, P7, P8, P9, P10, P15, P16: CONN_1
P30: CONN_01X07
R1, R2: 10k
R10: 10K
R27: 470
SW18: INT0
SW19: INT1
SW20: SPST
U1: 7805
U5: 40PIN_Breakout

Connections:
3.3V: IC2.2 (OUT), IC2.4 (OUT), P5.1, P5.2, P5.3, P5.4; also elsewhere on the board
9V/12V: C1.1, P3.1, P3.2, P3.3, P3.4, R10.2, SW20.2, U1.VI; also elsewhere on the board
+5V: D15.2 (K), IC2.3 (IN), P4.1, P4.2, P4.3, P4.4, P14.1, P29.4, P30.3, R1.1, R2.1, R27.2, U5.40; also elsewhere on the board
/S1: P1.1, R1.2, SW18.2
/S2: P1.2, R2.2, SW19.2
GND: C1.2, C2.2, D3.2 (K), D16.2 (K), IC2.1 (GND), K4.2 (PM), K4.3, P14.2, P25.1, P25.2, P25.3, P25.4, P26.1, P26.2, P26.3, P26.4, P27.1, P27.2, P27.3, P27.4, P29.3, P30.1, SW18.1, SW19.1, U1.GND, U5.39; also elsewhere on the board
unnamed: C2.1, D15.1 (A), U1.VO
unnamed: C3.1, JP10.2
unnamed: D3.1 (A), R10.1
unnamed: D16.1 (A), R27.1
unnamed: JP10.1, P30.7
unnamed: K4.1, SW20.1
unnamed: P2.3, U5.3
unnamed: P2.4, U5.4
unnamed: P2.5, U5.5
unnamed: P2.6, U5.6
unnamed: P2.7, U5.7
unnamed: P2.8, U5.8
unnamed: P2.9, U5.9
unnamed: P2.10, U5.10
unnamed: P2.11, U5.11
unnamed: P2.13, U5.13
unnamed: P2.14, U5.14
unnamed: P2.15, U5.15
unnamed: P2.16, U5.16
unnamed: P2.17, U5.17
unnamed: P2.18, U5.18
unnamed: P2.19, U5.19
unnamed: P2.20, U5.20
unnamed: P14.3, U5.38
unnamed: P14.4, U5.37
unnamed: P14.5, U5.36
unnamed: P14.6, U5.35
unnamed: P14.7, U5.34
unnamed: P14.8, U5.33
unnamed: P14.9, U5.32
unnamed: P14.10, U5.31
unnamed: P14.11, U5.30
unnamed: P14.12, U5.29
unnamed: P14.13, U5.28
unnamed: P14.14, U5.27
unnamed: P14.15, U5.26
unnamed: P14.16, U5.25
unnamed: P14.17, U5.24
unnamed: P14.18, U5.23
unnamed: P14.19, U5.22
unnamed: P14.20, U5.21
RST: C3.2, P2.12, U5.12
RX: P2.1, P29.2, P30.4, U5.1
TX: P2.2, P29.1, P30.5, U5.2

Notes on the sheet:
Power Supply
Create a 40 pin component with the name Explore MCU Breakout and also a footprint for it. Do not put it as individucal connectors, people may find difficult to understand what these connectors are!
If this LED indicates LED Power connect it to VBUS, don't leave stand alone
Add SPI LCD

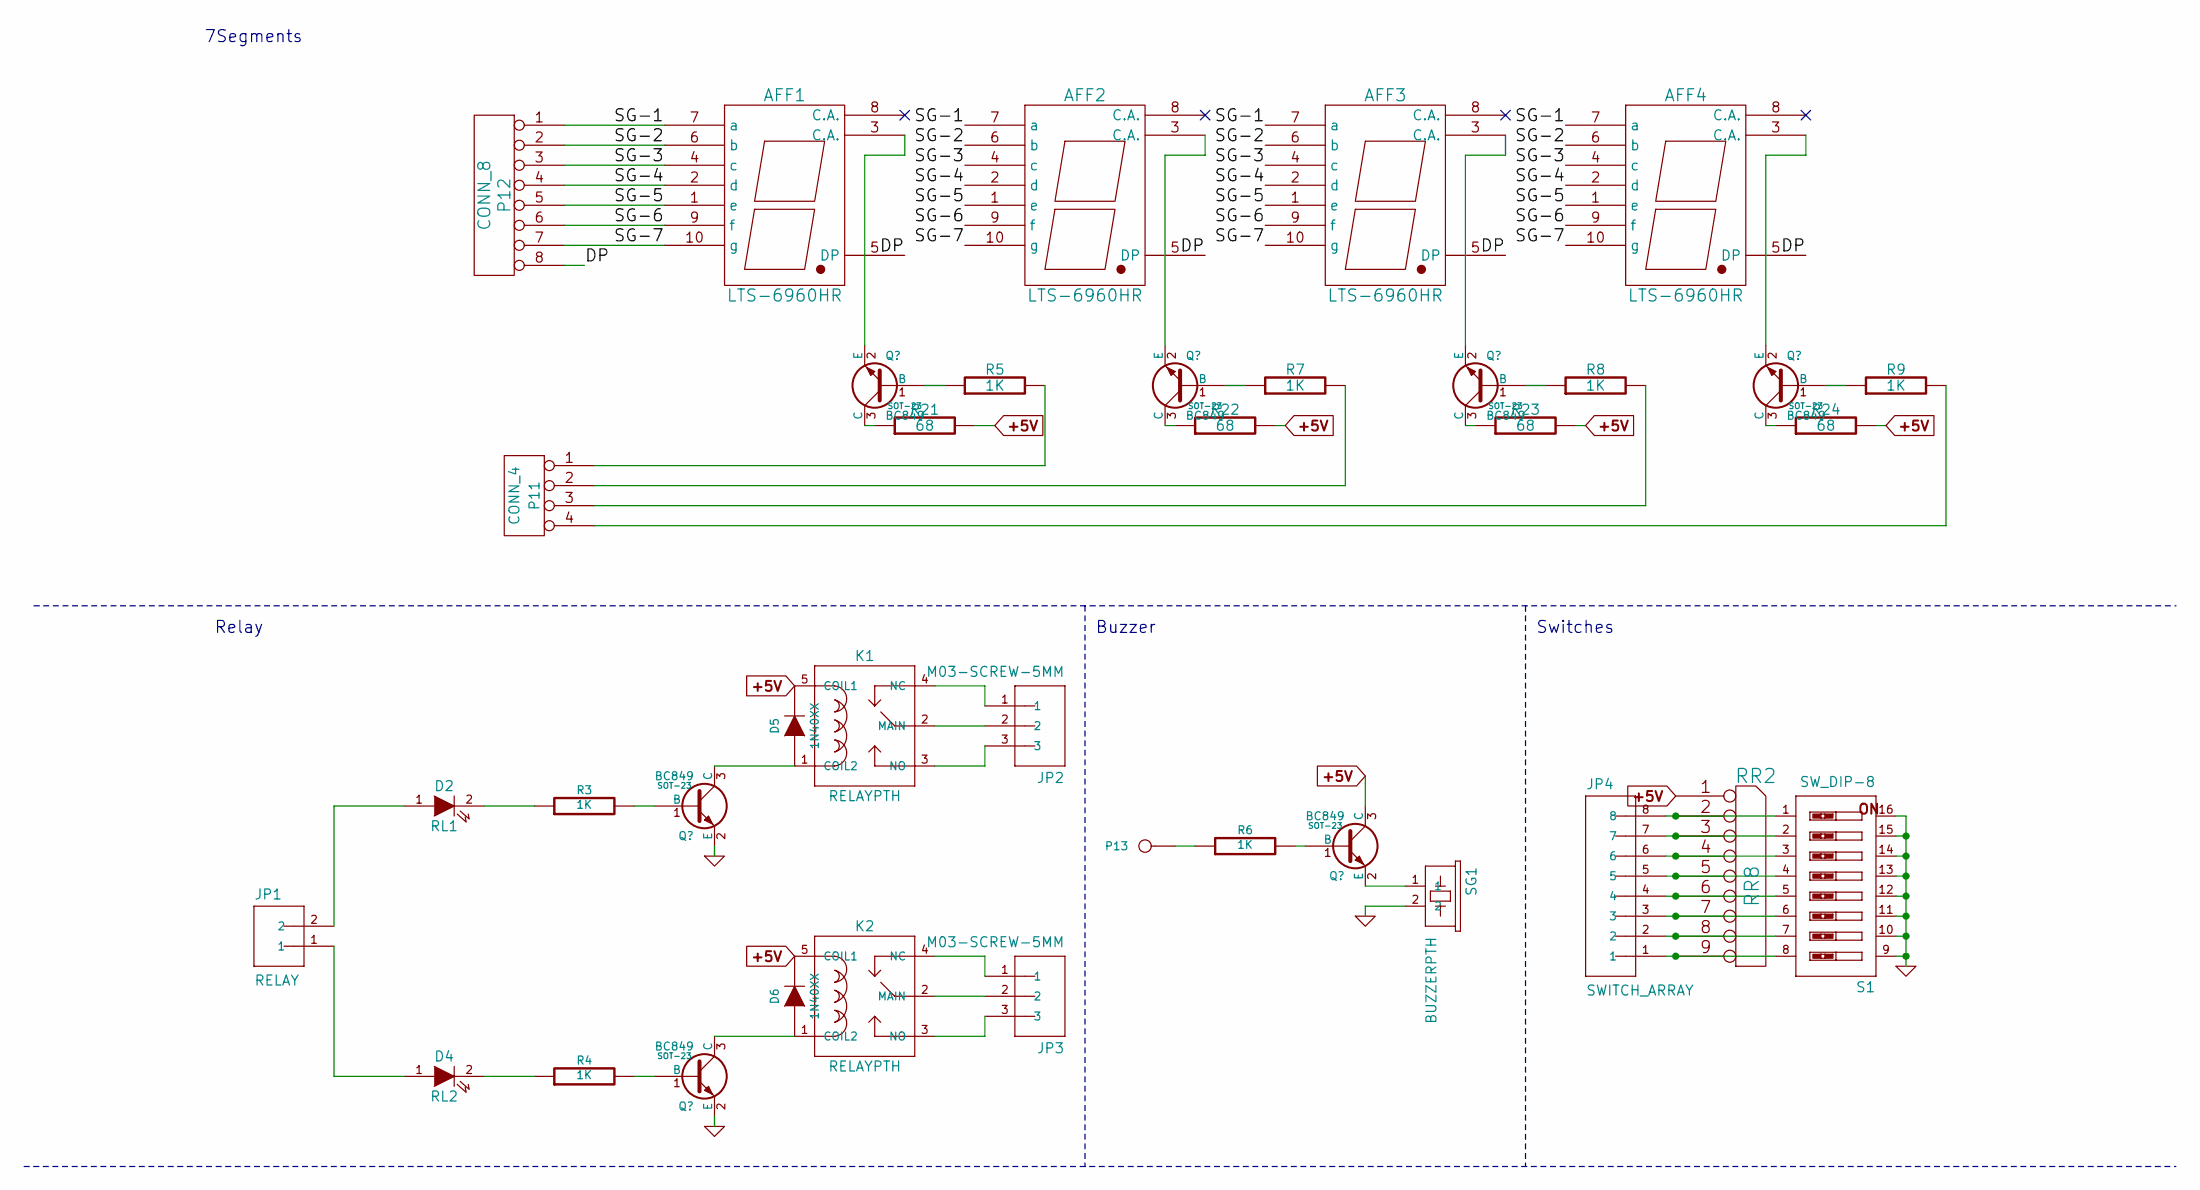
[picture p16: schematic file549BD866.sch]

Parts:
AFF1, AFF2, AFF3, AFF4: LTS-6960HR
D2: RL1
D4: RL2
D5, D6: 1N40XX
JP1: RELAY; SparkFun-JST-2-PTH-NS
JP2, JP3: M03-SCREW-5MM; SparkFun-SCREWTERMINAL-5MM-3
JP4: SWITCH_ARRAY; SparkFun-1X08_LOCK
K1, K2: RELAYPTH
P11: CONN_4
P12: CONN_8
P13: CONN_1
R3, R4, R6: 1K
R5, R7, R8, R9: 1K
R21, R22, R23, R24: 68
RR2: RR8
S1: SW_DIP-8; SparkFun-DIPSWITCH-08
SG1: BUZZERPTH; SparkFun-BUZZER-12MM

Connections:
+5V: D5.2 (K), D6.2 (K), K1.5 (COIL1), K2.5 (COIL1), R21.2, R22.2, R23.2, R24.2, RR2.1 (COM); also elsewhere on the board
/7Segment/DP: AFF1.5 (DP), AFF2.5 (DP), AFF3.5 (DP), AFF4.5 (DP), P12.8
/7Segment/SG-1: AFF1.7 (a), AFF2.7 (a), AFF3.7 (a), AFF4.7 (a), P12.1
/7Segment/SG-2: AFF1.6 (b), AFF2.6 (b), AFF3.6 (b), AFF4.6 (b), P12.2
/7Segment/SG-3: AFF1.4 (c), AFF2.4 (c), AFF3.4 (c), AFF4.4 (c), P12.3
/7Segment/SG-4: AFF1.2 (d), AFF2.2 (d), AFF3.2 (d), AFF4.2 (d), P12.4
/7Segment/SG-5: AFF1.1 (e), AFF2.1 (e), AFF3.1 (e), AFF4.1 (e), P12.5
/7Segment/SG-6: AFF1.9 (f), AFF2.9 (f), AFF3.9 (f), AFF4.9 (f), P12.6
/7Segment/SG-7: AFF1.10 (g), AFF2.10 (g), AFF3.10 (g), AFF4.10 (g), P12.7
GND: S1.9, S1.10, S1.11, S1.12, S1.13, S1.14, S1.15, S1.16, SG1.2; also elsewhere on the board
unnamed 46: AFF1.3 (C.A.); also elsewhere on the board
unnamed 48: AFF2.3 (C.A.); also elsewhere on the board
unnamed 50: AFF3.3 (C.A.); also elsewhere on the board
unnamed 52: AFF4.3 (C.A.); also elsewhere on the board
unnamed: D2.1 (A), JP1.2
unnamed: D2.2 (K), R3.1
unnamed: D4.1 (A), JP1.1
unnamed: D4.2 (K), R4.1
unnamed 61: D5.1 (A), K1.1 (COIL2); also elsewhere on the board
unnamed 62: D6.1 (A), K2.1 (COIL2); also elsewhere on the board
unnamed: JP2.1, K1.4 (NC)
unnamed: JP2.2, K1.2 (MAIN)
unnamed: JP2.3, K1.3 (NO)
unnamed: JP3.1, K2.4 (NC)
unnamed: JP3.2, K2.2 (MAIN)
unnamed: JP3.3, K2.3 (NO)
unnamed: JP4.1, RR2.9, S1.8
unnamed: JP4.2, RR2.8, S1.7
unnamed: JP4.3, RR2.7, S1.6
unnamed: JP4.4, RR2.6, S1.5
unnamed: JP4.5, RR2.5, S1.4
unnamed: JP4.6, RR2.4, S1.3
unnamed: JP4.7, RR2.3, S1.2
unnamed: JP4.8, RR2.2, S1.1
unnamed: P11.1, R5.2
unnamed: P11.2, R7.2
unnamed: P11.3, R8.2
unnamed: P11.4, R9.2
unnamed: P13.1, R6.1
unnamed 157: R3.2; also elsewhere on the board
unnamed 158: R4.2; also elsewhere on the board
unnamed 159: R5.1; also elsewhere on the board
unnamed 160: R21.1; also elsewhere on the board
unnamed 161: R7.1; also elsewhere on the board
unnamed 162: R22.1; also elsewhere on the board
unnamed 163: R6.2; also elsewhere on the board
unnamed 164: SG1.1; also elsewhere on the board
unnamed 165: R8.1; also elsewhere on the board
unnamed 166: R23.1; also elsewhere on the board
unnamed 167: R9.1; also elsewhere on the board
unnamed 168: R24.1; also elsewhere on the board

Notes on the sheet:
7Segments
Relay
Buzzer
Switches

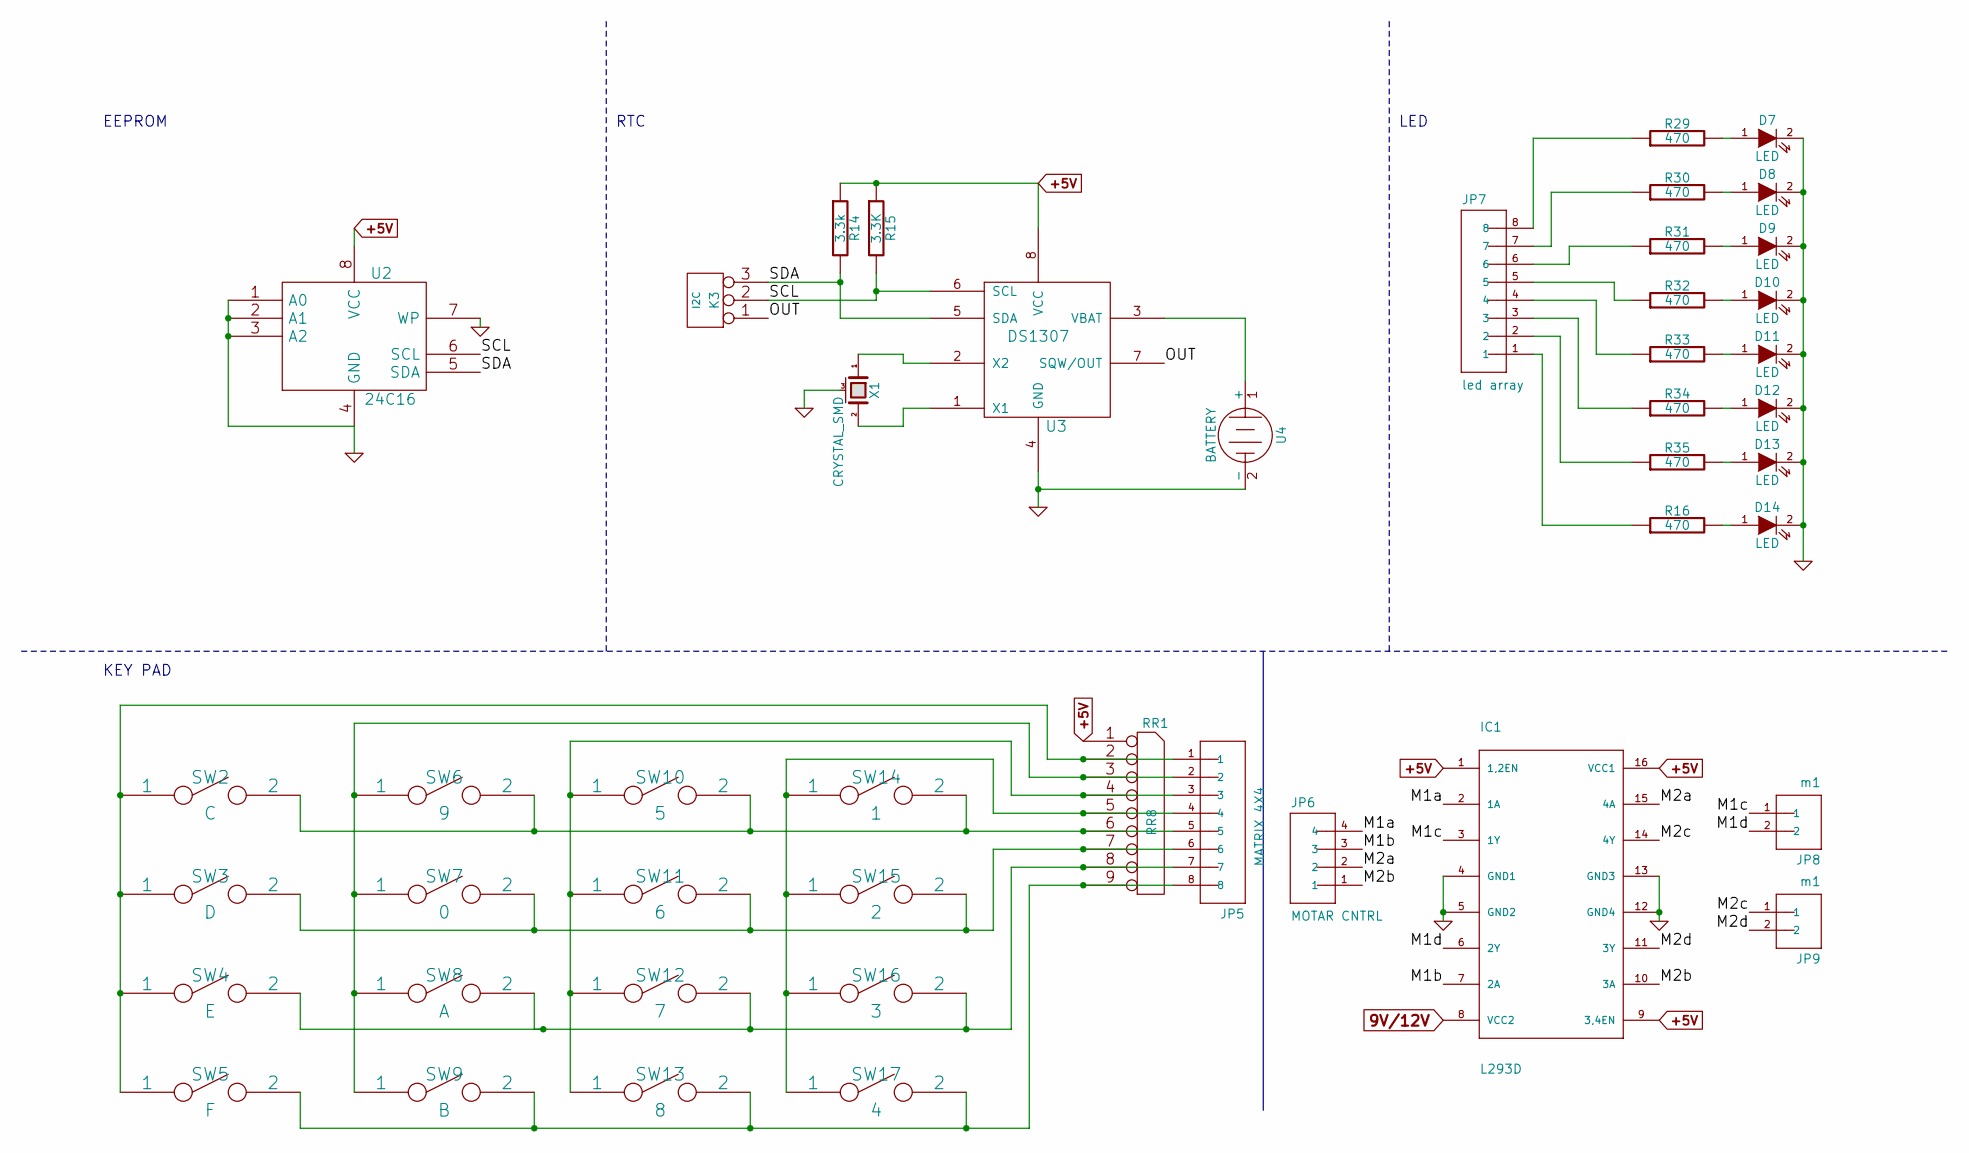
[picture p17: schematic file549BDEFB.sch]

Parts:
D7, D8, D9, D10, D11, D12, D13, D14: LED
IC1: L293D; sgs-thom-DIL16
JP5: MATRIX 4X4; SparkFun-1X08_LOCK
JP6: MOTAR CNTRL; SparkFun-JST-4-PTH
JP7: led array; SparkFun-1X08_LOCK
JP8, JP9: m1; SparkFun-JST-2-PTH-NS
K3: I2C
R14: 3.3k
R15: 3.3K
R16, R29, R30, R31, R32, R33, R34, R35: 470
RR1: RR8
SW2: C
SW3: D
SW4: E
SW5: F
SW6: 9
SW7: 0
SW8: A
SW9: B
SW10: 5
SW11: 6
SW12: 7
SW13: 8
SW14: 1
SW15: 2
SW16: 3
SW17: 4
U2: 24C16
U3: DS1307
U4: BATTERY
X1: CRYSTAL_SMD

Connections:
9V/12V: IC1.8 (VCC2); also elsewhere on the board
+5V: IC1.1 (1,2EN), IC1.9 (3,4EN), IC1.16 (VCC1), R14.1, R15.1, RR1.1 (COM), U2.8 (VCC), U3.8 (VCC); also elsewhere on the board
/Key Pad/M1a: IC1.2 (1A), JP6.4
/Key Pad/M1b: IC1.7 (2A), JP6.3
/Key Pad/M1c: IC1.3 (1Y), JP8.1
/Key Pad/M1d: IC1.6 (2Y), JP8.2
/Key Pad/M2a: IC1.15 (4A), JP6.2
/Key Pad/M2b: IC1.10 (3A), JP6.1
/Key Pad/M2c: IC1.14 (4Y), JP9.1
/Key Pad/M2d: IC1.11 (3Y), JP9.2
/Key Pad/OUT: K3.1, U3.7 (SQW/OUT)
/Key Pad/SCL: K3.2 (PM), R15.2, U2.6 (SCL), U3.6 (SCL)
/Key Pad/SDA: K3.3, R14.2, U2.5 (SDA), U3.5 (SDA)
GND: D7.2 (K), D8.2 (K), D9.2 (K), D10.2 (K), D11.2 (K), D12.2 (K), D13.2 (K), D14.2 (K), IC1.4 (GND1), IC1.5 (GND2), IC1.12 (GND4), IC1.13 (GND3), U2.1 (A0), U2.2 (A1), U2.3 (A2), U2.4 (GND), U2.7 (WP), U3.4 (GND), U4.2 (-), X1.3 (case); also elsewhere on the board
unnamed: D7.1 (A), R29.2
unnamed: D8.1 (A), R30.2
unnamed: D9.1 (A), R31.2
unnamed: D10.1 (A), R32.2
unnamed: D11.1 (A), R33.2
unnamed: D12.1 (A), R34.2
unnamed: D13.1 (A), R35.2
unnamed: D14.1 (A), R16.2
unnamed: JP5.1, RR1.2, SW2.1, SW3.1, SW4.1, SW5.1
unnamed: JP5.2, RR1.3, SW6.1, SW7.1, SW8.1, SW9.1
unnamed: JP5.3, RR1.4, SW10.1, SW11.1, SW12.1, SW13.1
unnamed: JP5.4, RR1.5, SW14.1, SW15.1, SW16.1, SW17.1
unnamed: JP5.5, RR1.6, SW2.2, SW6.2, SW10.2, SW14.2
unnamed: JP5.6, RR1.7, SW3.2, SW7.2, SW11.2, SW15.2
unnamed: JP5.7, RR1.8, SW4.2, SW8.2, SW12.2, SW16.2
unnamed: JP5.8, RR1.9, SW5.2, SW9.2, SW13.2, SW17.2
unnamed: JP7.1, R16.1
unnamed: JP7.2, R35.1
unnamed: JP7.3, R34.1
unnamed: JP7.4, R33.1
unnamed: JP7.5, R32.1
unnamed: JP7.6, R31.1
unnamed: JP7.7, R30.1
unnamed: JP7.8, R29.1
unnamed: U3.1 (X1), X1.2
unnamed: U3.2 (X2), X1.1
unnamed: U3.3 (VBAT), U4.1 (+)

Notes on the sheet:
EEPROM
RTC
LED
KEY PAD

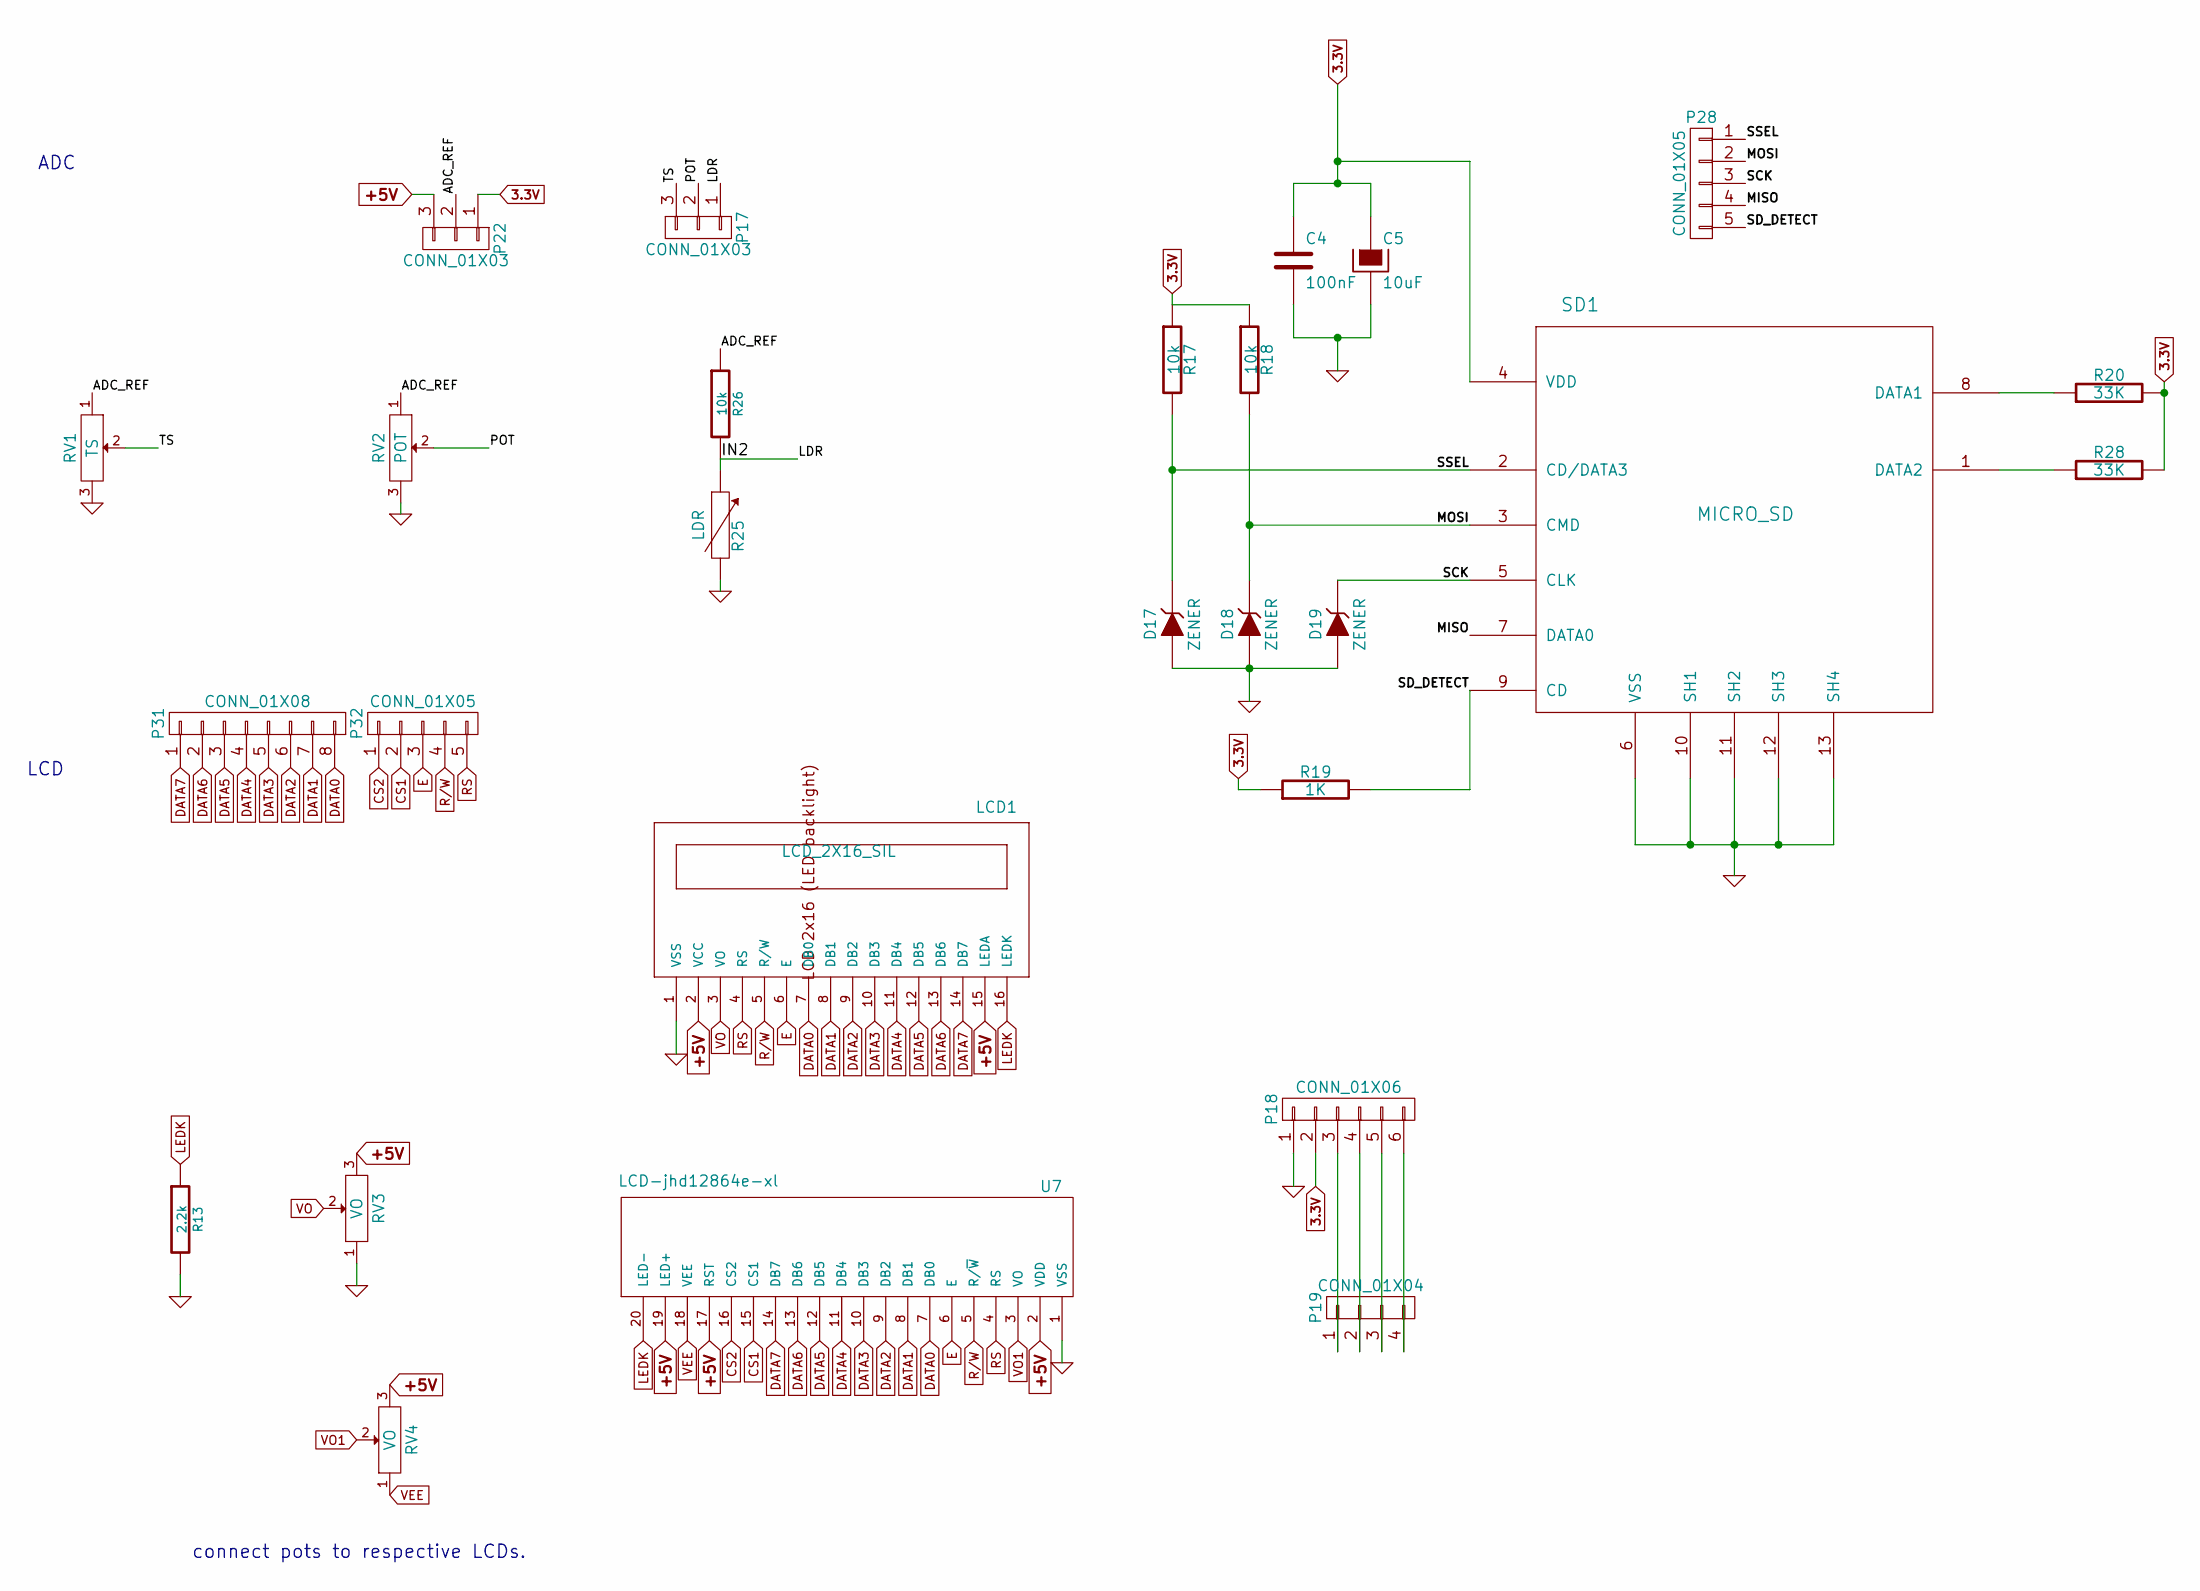
[picture p18: schematic file549BE66B.sch]

Parts:
C4: 100nF
C5: 10uF
D17, D18, D19: ZENER
LCD1: LCD_2X16_SIL; lcd_2x16_led_backlight-HY-1602F
P17, P22: CONN_01X03
P18: CONN_01X06
P19: CONN_01X04
P28, P32: CONN_01X05
P31: CONN_01X08
R13: 2.2k
R17, R18: 10k
R19: 1K
R20, R28: 33K
R25: LDR
R26: 10k
RV1: TS
RV2: POT
RV3, RV4: VO
SD1: MICRO_SD
U7: LCD-jhd12864e-xl

Connections:
3.3V: C4.1, C5.1, P18.2, P22.1, R17.1, R18.1, R19.1, R20.2, R28.2, SD1.4 (VDD); also elsewhere on the board
+5V: LCD1.2 (VCC), LCD1.15 (LEDA), P22.3, RV3.3, RV4.3, U7.2 (VDD), U7.17 (RST), U7.19 (LED+); also elsewhere on the board
/ADC/ADC_REF: P22.2, R26.1, RV1.1, RV2.1
/ADC/IN2: P17.1, R25.1, R26.2
/ADC/MISO: P28.4, SD1.7 (DATA0)
/ADC/MOSI: D18.2 (K), P28.2, R18.2, SD1.3 (CMD)
/ADC/POT: P17.2, RV2.2
/ADC/SCK: D19.2 (K), P28.3, SD1.5 (CLK)
/ADC/SD_DETECT: P28.5, R19.2, SD1.9 (CD)
/ADC/SSEL: D17.2 (K), P28.1, R17.2, SD1.2 (CD/DATA3)
/ADC/TS: P17.3, RV1.2
CS1: P32.2, U7.15 (CS1)
CS2: P32.1, U7.16 (CS2)
DATA0: LCD1.7 (DB0), P31.8, U7.7 (DB0)
DATA1: LCD1.8 (DB1), P31.7, U7.8 (DB1)
DATA2: LCD1.9 (DB2), P31.6, U7.9 (DB2)
DATA3: LCD1.10 (DB3), P31.5, U7.10 (DB3)
DATA4: LCD1.11 (DB4), P31.4, U7.11 (DB4)
DATA5: LCD1.12 (DB5), P31.3, U7.12 (DB5)
DATA6: LCD1.13 (DB6), P31.2, U7.13 (DB6)
DATA7: LCD1.14 (DB7), P31.1, U7.14 (DB7)
E: LCD1.6 (E), P32.3, U7.6 (E)
GND: C4.2, C5.2, D17.1 (A), D18.1 (A), D19.1 (A), LCD1.1 (VSS), P18.1, R13.2, R25.2, RV1.3, RV2.3, RV3.1, SD1.6 (VSS), SD1.10 (SH1), SD1.11 (SH2), SD1.12 (SH3), SD1.13 (SH4), U7.1 (VSS); also elsewhere on the board
LEDK: LCD1.16 (LEDK), R13.1, U7.20 (LED-)
unnamed: P18.3, P19.1
unnamed: P18.4, P19.2
unnamed: P18.5, P19.3
unnamed: P18.6, P19.4
unnamed: R20.1, SD1.8 (DATA1)
unnamed: R28.1, SD1.1 (DATA2)
R/W: LCD1.5 (R/W), P32.4, U7.5 (R/~W)
RS: LCD1.4 (RS), P32.5, U7.4 (RS)
VEE: RV4.1, U7.18 (VEE)
VO: LCD1.3 (VO), RV3.2
VO1: RV4.2, U7.3 (VO)

Notes on the sheet:
ADC
LCD
connect pots to respective LCDs.
