ExploreEmbedded/ATmega32_ExploreUltraAvrDevKit/Hardware Design/Explore Ultra One base board/MCU_BaseBoard.kicad_pcb

## KiCad design Hardware Design/Explore Ultra One base board/MCU_BaseBoard.kicad_pcb (continued)

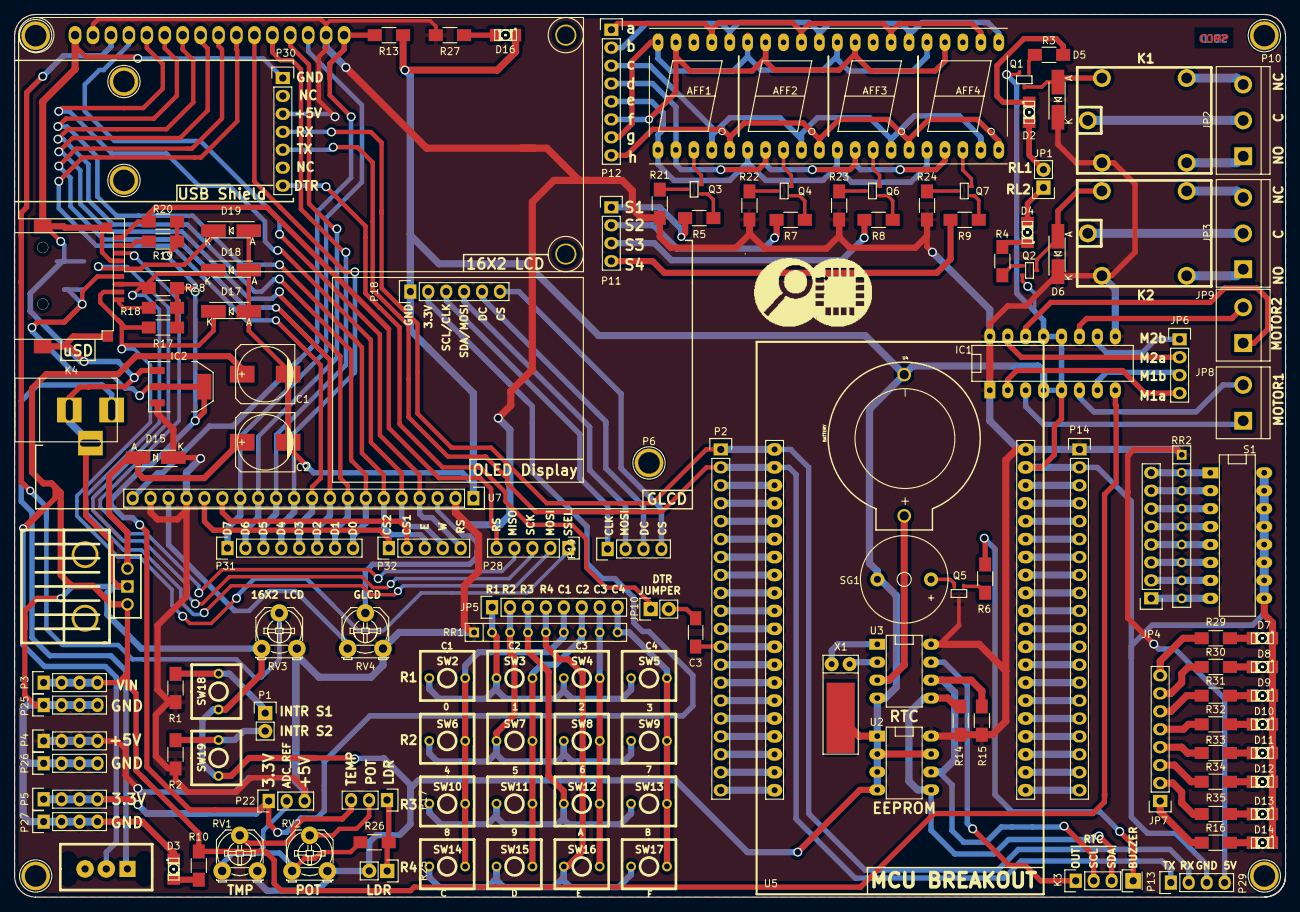
[picture p19: board MCU_BaseBoard.kicad_pcb from above]

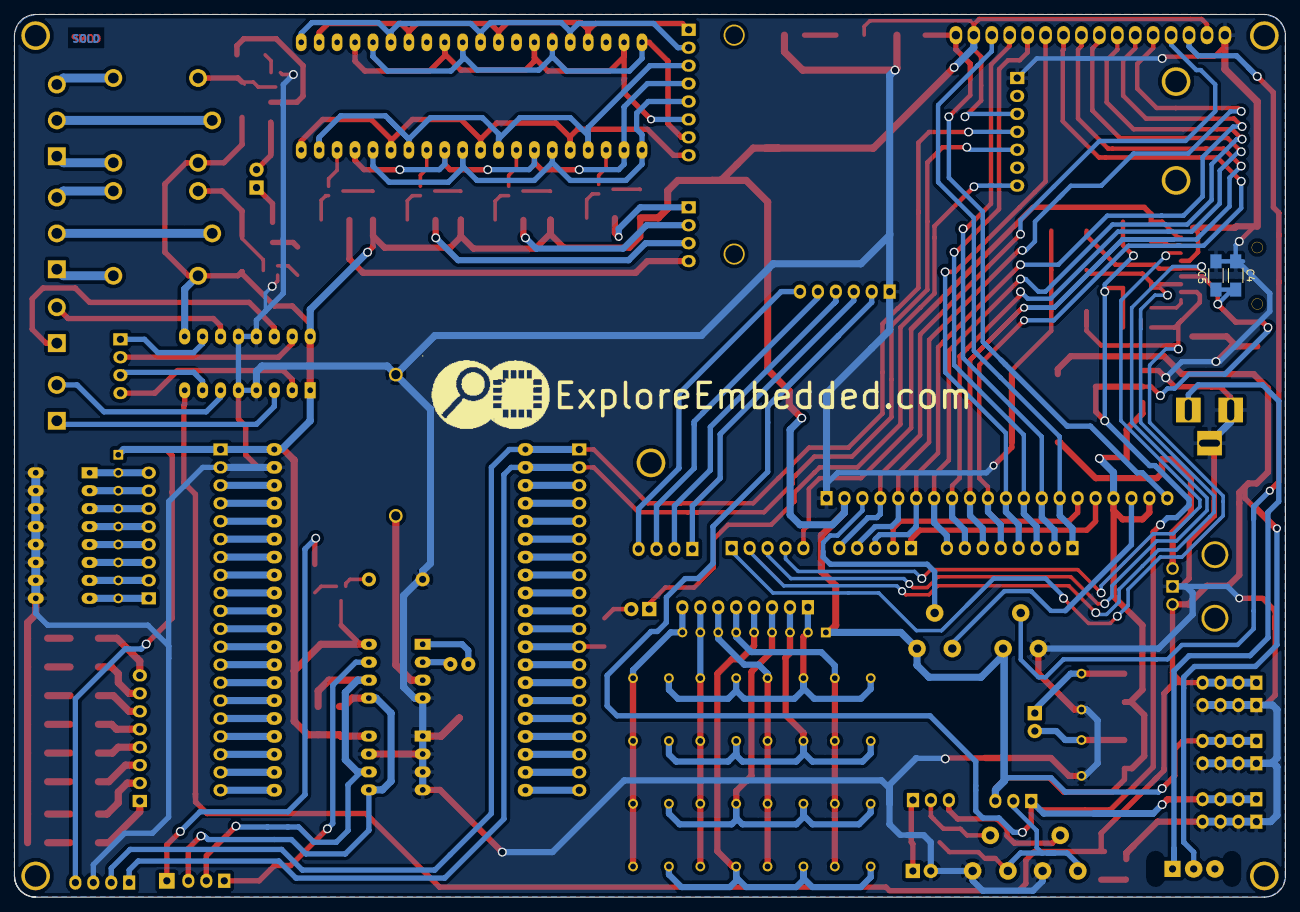
[picture p20: board MCU_BaseBoard.kicad_pcb from below]

Board: 2 copper layers, 180.0 x 125.0 mm, 149 parts (3 on the bottom side), 169 nets.

Other parts of the board:
EE_LOGO: EE_LOGO(2)
EE_LOGO#2: EE_LOGO(2)
Q1, Q2, Q3, Q4, Q5, Q6, Q7: BC849; sc70

Their connections:
+5V: Q5.3; also elsewhere on the board
GND: Q1.2, Q2.2; also elsewhere on the board
unnamed 46: Q3.2; also elsewhere on the board
unnamed 48: Q4.2; also elsewhere on the board
unnamed 50: Q6.2; also elsewhere on the board
unnamed 52: Q7.2; also elsewhere on the board
unnamed 61: Q1.3; also elsewhere on the board
unnamed 62: Q2.3; also elsewhere on the board
unnamed 157: Q1.1; also elsewhere on the board
unnamed 158: Q2.1; also elsewhere on the board
unnamed 159: Q3.1; also elsewhere on the board
unnamed 160: Q3.3; also elsewhere on the board
unnamed 161: Q4.1; also elsewhere on the board
unnamed 162: Q4.3; also elsewhere on the board
unnamed 163: Q5.1; also elsewhere on the board
unnamed 164: Q5.2; also elsewhere on the board
unnamed 165: Q6.1; also elsewhere on the board
unnamed 166: Q6.3; also elsewhere on the board
unnamed 167: Q7.1; also elsewhere on the board
unnamed 168: Q7.3; also elsewhere on the board
