ExploreEmbedded/ATmega32_ExploreUltraAvrDevKit/(commit log)

2016-03-19 fritzing diagram for interrupt
    [EXT_Interrupt_Edge_Level.fzz]
2016-03-24 Timer and Interrupt code updated
    [LCD 16X2_AVR.fzz]
2016-04-02 Tutorial Code updated
    [10b-Keypad_LCD.fzz, Controlling AC device using Relay_AVR.fzz, Interfacing KS0108 based JHD12864E Graphics LCD with Atmega32 .fzz, Interfacing Seven Segment Displays with AVR.fzz, LCD 16X2_AVR.fzz, Reading Temperature with AVR ADC.fzz, Reading Temperature with AVR ADC_TEMP.fzz, Real Time Clock(DS1307) with AVR_LCD.fzz]
2016-04-19 Tutorial codes updated
    Tutorial codes updated
    [40pin_AVRMCU.csv, 40pin_AVRMCU.kicad_pcb, 40pin_AVRMCU.sch, BOM.xlsx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]
2016-05-11 Updated the Test Code
    Updated the Test Code for ADC, SevenSegment and Eeprom
2017-03-29 Updated Ad, PWM, Timers
    Updated Ad, PWM, Timers
2017-04-13 Updated Fuse Bits in Readme
    Updated Fuse Bits in Readme
2017-04-13 Updated Fuse bits infor in read me
    Updated Fuse bits infor in read me
2017-04-13 Updated fuse bits info in readme
    Updated fuse bits info in readme
